YesidAlmanzaGamba/Thesis-Flight-Controller-Fixed-Wing/Documento/Sections/Abstract.tex

  \section{Abstract}

  This thesis addresses the design and implementation of a flight controller for fixed-wing unmanned aerial vehicles (UAVs), along with a ground control station for remote supervision. The proposed system enhances actuator capacity, integrates advanced sensors such as altimeters, barometers, GPS, and inertial sensors, and enables real-time visualization of critical parameters. Additionally, a system was developed to monitor and reconstruct the flight trajectory using geolocation and altitude data. This advancement represents a significant contribution to industrial applications requiring precision and constant UAV monitoring. A notable aspect is the transition from the traditional STM32 architecture to the ESP32-S3, improving system capabilities. This innovation significantly enhances data management and operational efficiency, providing UAV operators and researchers with a robust and reliable flight control system.\vspace{30 px}

\begin{center}
    \textbf{\LARGE{Resumen}} 
\end{center}

\vspace{10 px}

Esta tesis aborda el diseño e implementación de un controlador de vuelo para vehículos aéreos no tripulados (UAV) de ala fija, junto con una estación de control en tierra para supervisión remota. Se propone un sistema que mejora la capacidad de actuadores, integra sensores avanzados como altímetros, barómetros, GPS y sensores inerciales, y permite la visualización de parámetros críticos en tiempo real. Adicionalmente, se diseñó un sistema para monitorear y reconstruir la trayectoria de vuelo mediante datos de geolocalización y altitud. Este avance representa un aporte significativo para aplicaciones industriales que requieren precisión y monitoreo constante de UAVs. Un aspecto notable es el cambio de la arquitectura tradicional STM32 a la ESP32-S3, mejorando las capacidades del sistema. Esta innovación mejora significativamente la gestión de datos y la eficiencia operativa, impactando a operadores e investigadores de UAVs al proporcionar un sistema de control de vuelo robusto y fiable.
