YesidAlmanzaGamba/Thesis-Flight-Controller-Fixed-Wing/Documento/main.tex

\makeatletter
\providecommand{\sf@counterlist}{}
\makeatother
\documentclass[journal,onecolumn]{IEEEtran}
\usepackage[letterpaper,bindingoffset=0.0in,left=28mm,right=28mm,top=28mm,bottom=28mm,%
            footskip=16mm]{geometry}
\usepackage[table,xcdraw]{xcolor}
\usepackage{amsmath,amsthm,amssymb,amsfonts}
\usepackage[utf8]{inputenc}
\usepackage[english, spanish]{babel}
\setlength{\parindent}{0in}
\usepackage{float}
\usepackage[export]{adjustbox}
\usepackage[labelfont=bf]{caption}
\usepackage{subcaption}
\usepackage[arrowdel]{physics}
\usepackage{wrapfig}
\usepackage{mathtools}
\usepackage{bm}
\usepackage{esvect}
\usepackage{array}
\usepackage[hidelinks, colorlinks=true, urlcolor=gray, citecolor=gray]{hyperref}
\usepackage{enumerate}
\usepackage{chemfig}
\usepackage{enumitem}
\usepackage{sectsty}
\allsectionsfont{\bfseries\centering}
\usepackage{url}
\usepackage[T1]{fontenc}
\usepackage{titling}
\usepackage{letltxmacro}
\usepackage{textcomp}
\usepackage{fancyhdr}
\usepackage{fancyvrb}
\usepackage{lipsum}
\usepackage{authblk}
\usepackage{multirow}
\usepackage{makecell}
\usepackage{multicol}
\usepackage{resizegather}
\usepackage{subfig}
\usepackage{subfiles}
\usepackage{import}
\hyphenation{op-tical net-works semi-conduc-tor}
\usepackage{listings}
\usepackage{blindtext}
\setlength{\columnsep}{1cm}
\usepackage{appendix}
\usepackage{tocloft}
\usepackage{csquotes}
\usepackage[backend=biber,style=ieee]{biblatex}
\addbibresource{biblio.bib} % Add your .bib file here
\bibliography{references}
\usepackage{bookmark}
\usepackage{graphicx}
\usepackage{pgfgantt}
\usepackage{sectsty}
\usepackage{listings}
\usepackage{xcolor}
\usepackage{caption} % Asegúrate de que esta línea está presente
\usepackage{verbatim}
\definecolor{codegreen}{rgb}{0,0.6,0}
\definecolor{codegray}{rgb}{0.5,0.5,0.5}
\definecolor{codepurple}{rgb}{0.58,0,0.82}
\definecolor{backcolour}{rgb}{0.95,0.95,0.92}

\lstdefinestyle{mystyle}{
    backgroundcolor=\color{backcolour},   
    commentstyle=\color{codegreen},
    keywordstyle=\color{magenta},
    numberstyle=\tiny\color{codegray},
    stringstyle=\color{codepurple},
    basicstyle=\ttfamily\footnotesize,
    breakatwhitespace=false,         
    breaklines=true,                 
    captionpos=b,                    
    keepspaces=true,                 
    numbers=left,                    
    numbersep=5pt,                  
    showspaces=false,                
    showstringspaces=false,
    showtabs=false,                  
    tabsize=2
}

\lstset{style=mystyle}

\usepackage{titlesec}
\titleformat{\paragraph}[runin]
  {\normalfont\normalsize\bfseries} % Formato de texto
  {\thesubparagraph}{1em}{}         % Numeración y espaciado
\titlespacing*{\paragraph}{0pt}{1.5ex plus 1ex minus .2ex}{1em}

% Cambiar el estilo de numeración de secciones a números arábigos
\renewcommand{\thesection}{\arabic{section}}
\renewcommand{\thesubsection}{\thesection.\arabic{subsection}}
\renewcommand{\thesubsubsection}{\thesubsection.\arabic{subsubsection}}

\newenvironment{sbmatrix}[1]
 {\def\mysubscript{#1}\mathop\bgroup\begin{bmatrix}}
 {\end{bmatrix}\egroup_{\textstyle\mathstrut\mysubscript}}

%\input{Comandos.tex} %Incluye todos los comandos usados. 
%***************************%

\input{Configuracion.tex} %Incluye todos los cambios en configuración del documento. 

%***************************%

%Comienzo del documento.
\date{}

\begin{document}

    \begin{titlepage}
    \centering
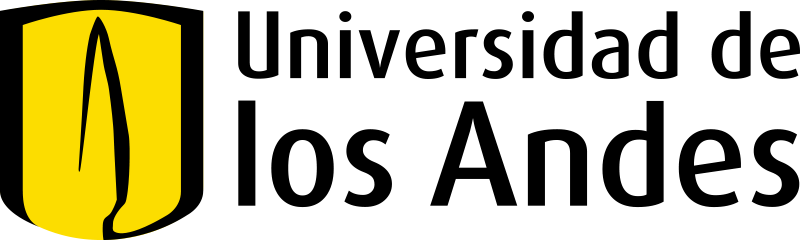
[picture p83: Documento/Documentos/logo_uniandes.png]
    \\

    \vspace{1cm}
    %{\scshape\Large Departamento de Ingeniería Electrónica Universidad de los Andes\par}
    \vspace{3cm}
    {\scshape \Large \textbf{desarrollo e implementación de un controlador de vuelo y estación de control de tierra para un uav de ala fija } \par}
    \vspace{3cm}
    {\itshape\Large Proyecto de Grado \par}
    \vfill
    {\itshape\Large Programa de Ingeniería electrónica Universidad de los Andes\par}
    {\Large Autor: \par}
    {\Large Yesid Camilo Almanza Gamba \par}
    \vfill
    {\Large Profesora Asesora: \par}
    {\Large Alba Ávila Bernal  \par}
    \vfill
    {\Large Junio 2024 \par}
    \end{titlepage}

\clearpagen 

\pagestyle{plain}
\tableofcontents
\clearpage
\makeatletter
\listoffigures
\makeatother
\clearpage
\makeatletter
\listoftables
\makeatother
\clearpage
\input{Sections/Abstract}
\clearpage
\input{Sections/Agradecimientos}
\clearpage

\input{Sections/Introducción}
\input{Sections/Estado_del_Arte}
\clearpage
\input{Sections/Planteamiento_problema}
\clearpage
\input{Sections/Objetivos}
\clearpage
\input{Sections/Marco Teórico}
\clearpage
\input{Sections/Metodología}
\clearpage
\input{Sections/Hardware}
\input{Sections/Enclousure}
\input{Sections/Firmware}
\clearpage
\input{Sections/Interfaz}
\clearpage

\input{Sections/Costos}
\clearpage
\input{Sections/pruebas_funcionamiento}
%\input{Sections/vuelo}
%\clearpage
\input{Sections/prueba_vuelo}
\clearpage
\input{Sections/resultados}

\clearpage

\input{Sections/conclusiones}
\clearpage
\printbibliography
\input{Sections/anexos}
\clearpage
\begin{comment}
 sdfsd
\end{comment}

\end{document}
