YesidAlmanzaGamba/Thesis-Flight-Controller-Fixed-Wing/Documento/Documentos/Yumbo-Solar.png

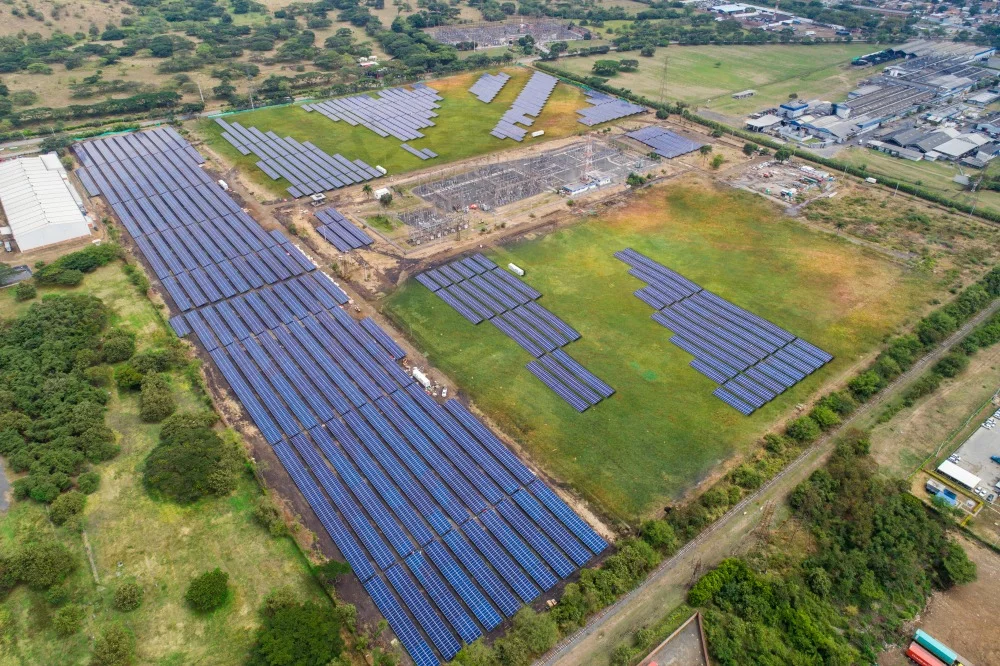
Documento/Documentos/Yumbo-Solar.png
