YesidAlmanzaGamba/Thesis-Flight-Controller-Fixed-Wing/Documento/Imagenes/Anexos/costos.png

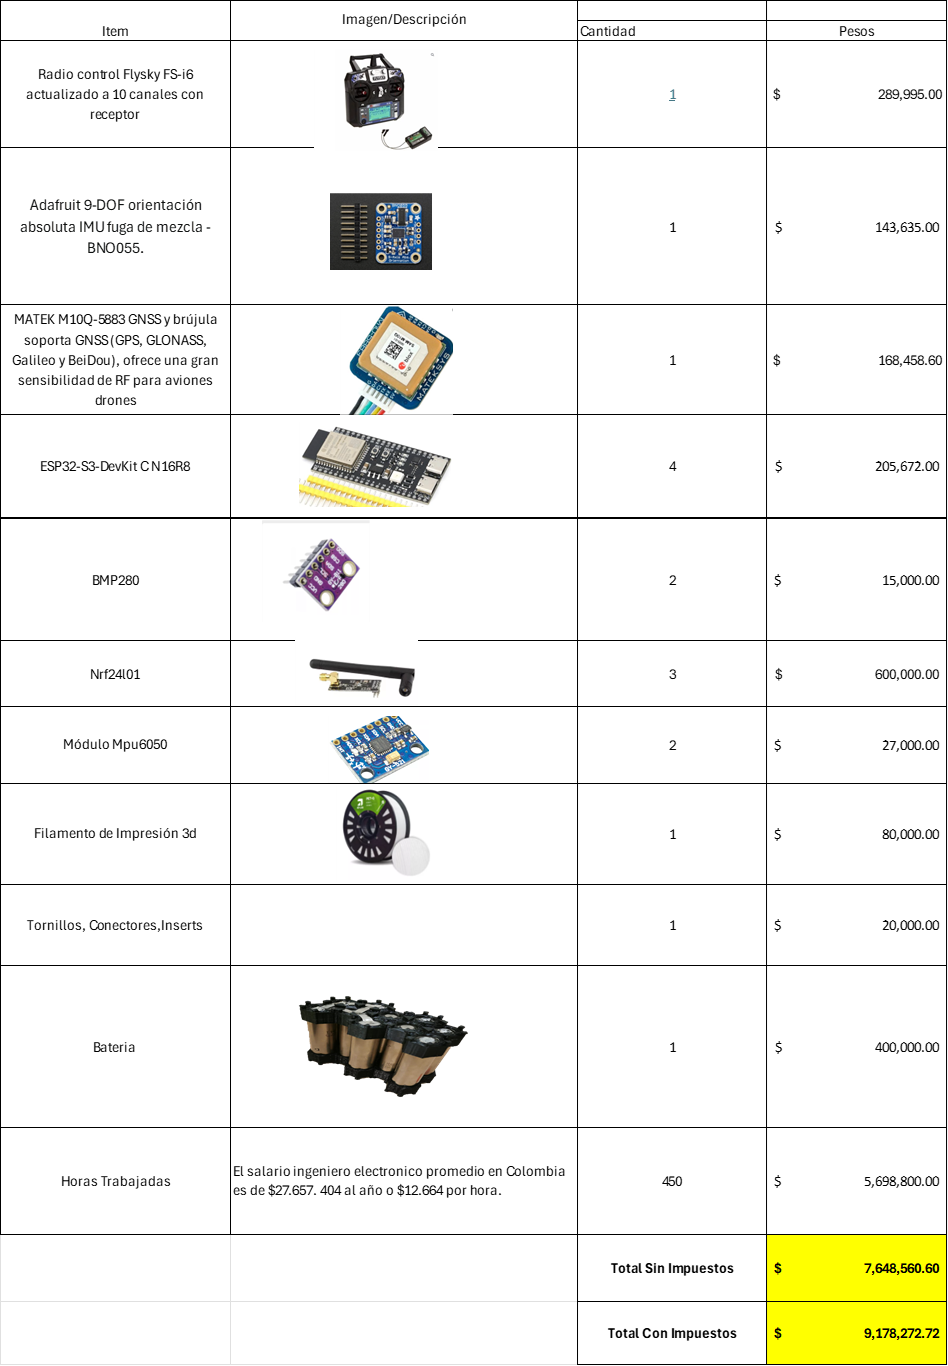
Documento/Imagenes/Anexos/costos.png
