YesidAlmanzaGamba/Thesis-Flight-Controller-Fixed-Wing/Documento/Imagenes/Marco Teorico/modulo-lector-de-memoria-micro-sd.jpg

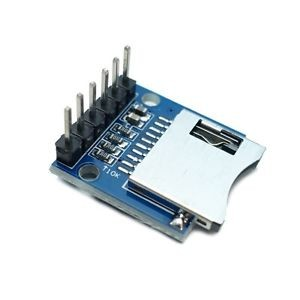
Documento/Imagenes/Marco Teorico/modulo-lector-de-memoria-micro-sd.jpg
