YesidAlmanzaGamba/Thesis-Flight-Controller-Fixed-Wing/Documento/Imagenes/Marco Teorico/waitpoints.png

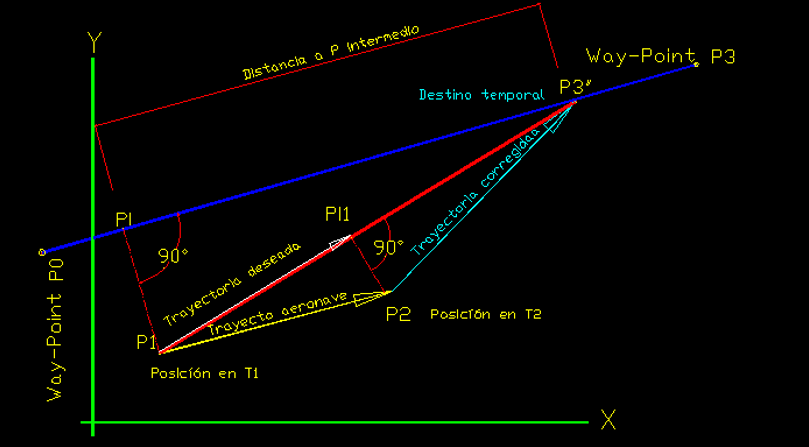
Documento/Imagenes/Marco Teorico/waitpoints.png
