YesidAlmanzaGamba/Thesis-Flight-Controller-Fixed-Wing/Documento/Imagenes/Metodologia/arquiectura.png

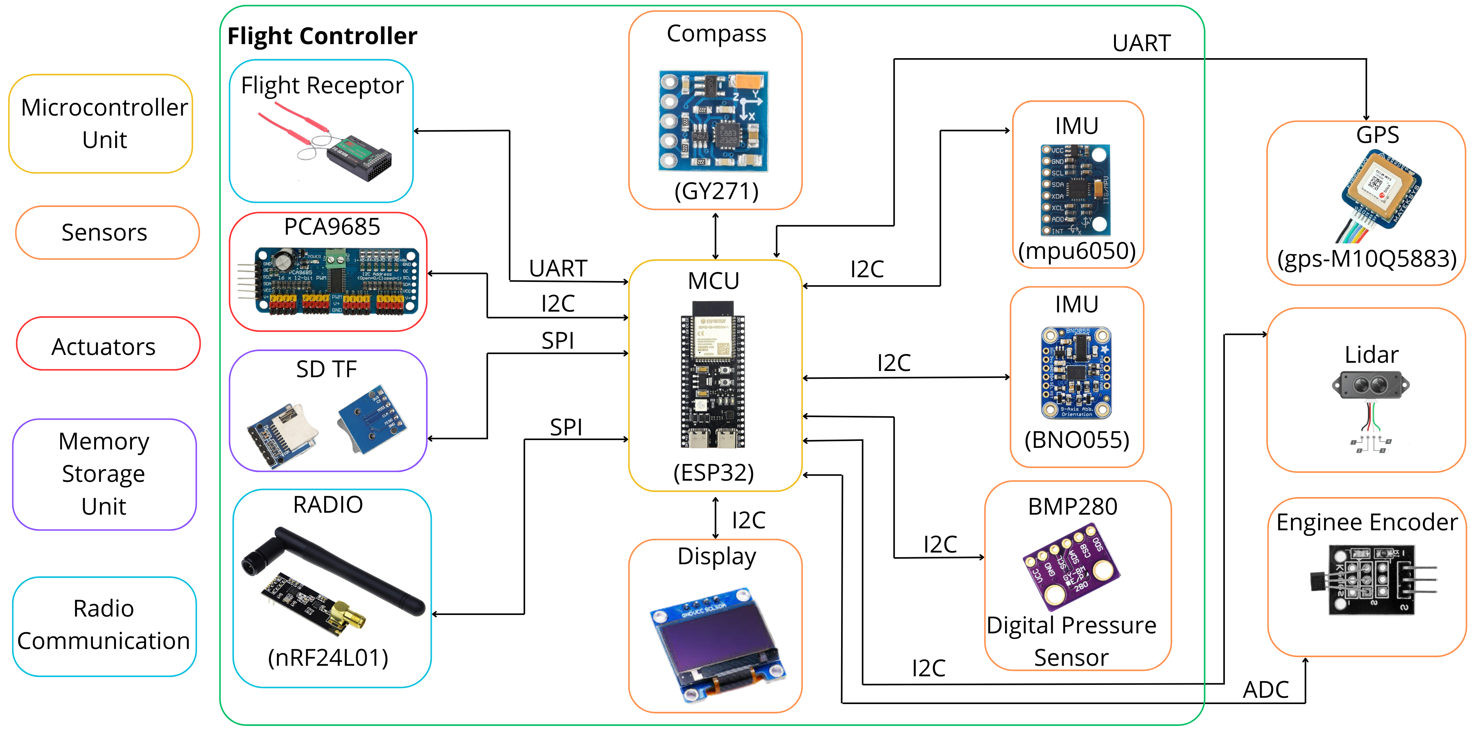
Documento/Imagenes/Metodologia/arquiectura.png
