YesidAlmanzaGamba/Thesis-Flight-Controller-Fixed-Wing/Documento/Imagenes/Metodologia/bloques.png

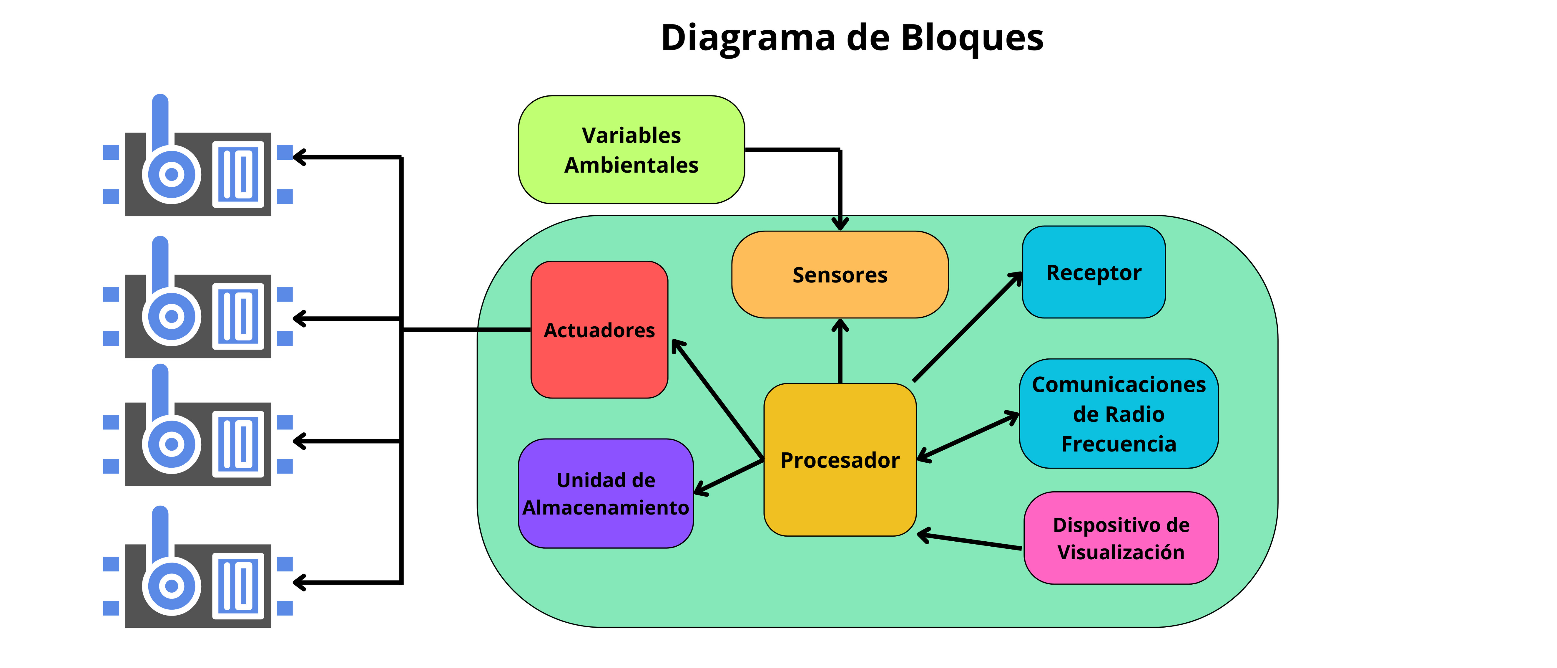
Documento/Imagenes/Metodologia/bloques.png
