YesidAlmanzaGamba/Thesis-Flight-Controller-Fixed-Wing/Documento/Imagenes/Metodologia/PCB_2.0.png

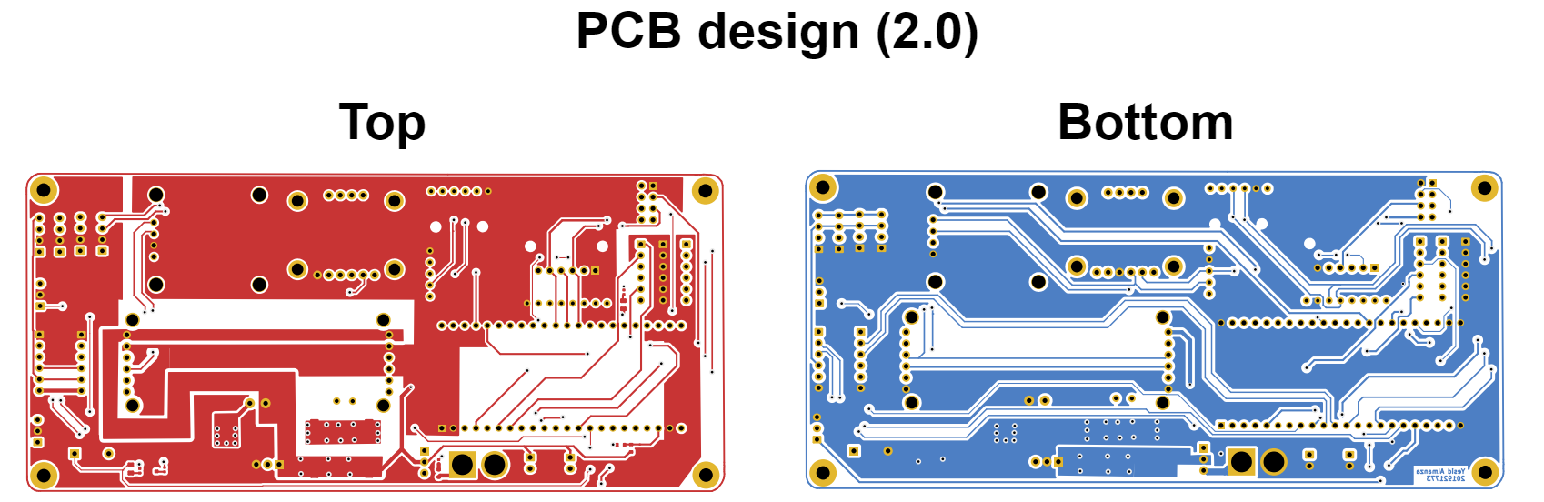
Documento/Imagenes/Metodologia/PCB_2.0.png
