YesidAlmanzaGamba/Thesis-Flight-Controller-Fixed-Wing/Documento/Imagenes/Metodologia/sujecion_electronica.png

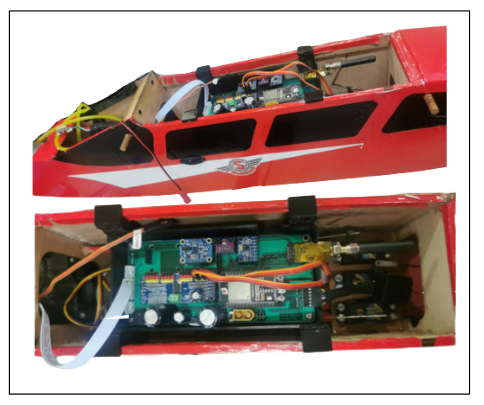
Documento/Imagenes/Metodologia/sujecion_electronica.png
