YesidAlmanzaGamba/Thesis-Flight-Controller-Fixed-Wing/Documento/presupuesto.png

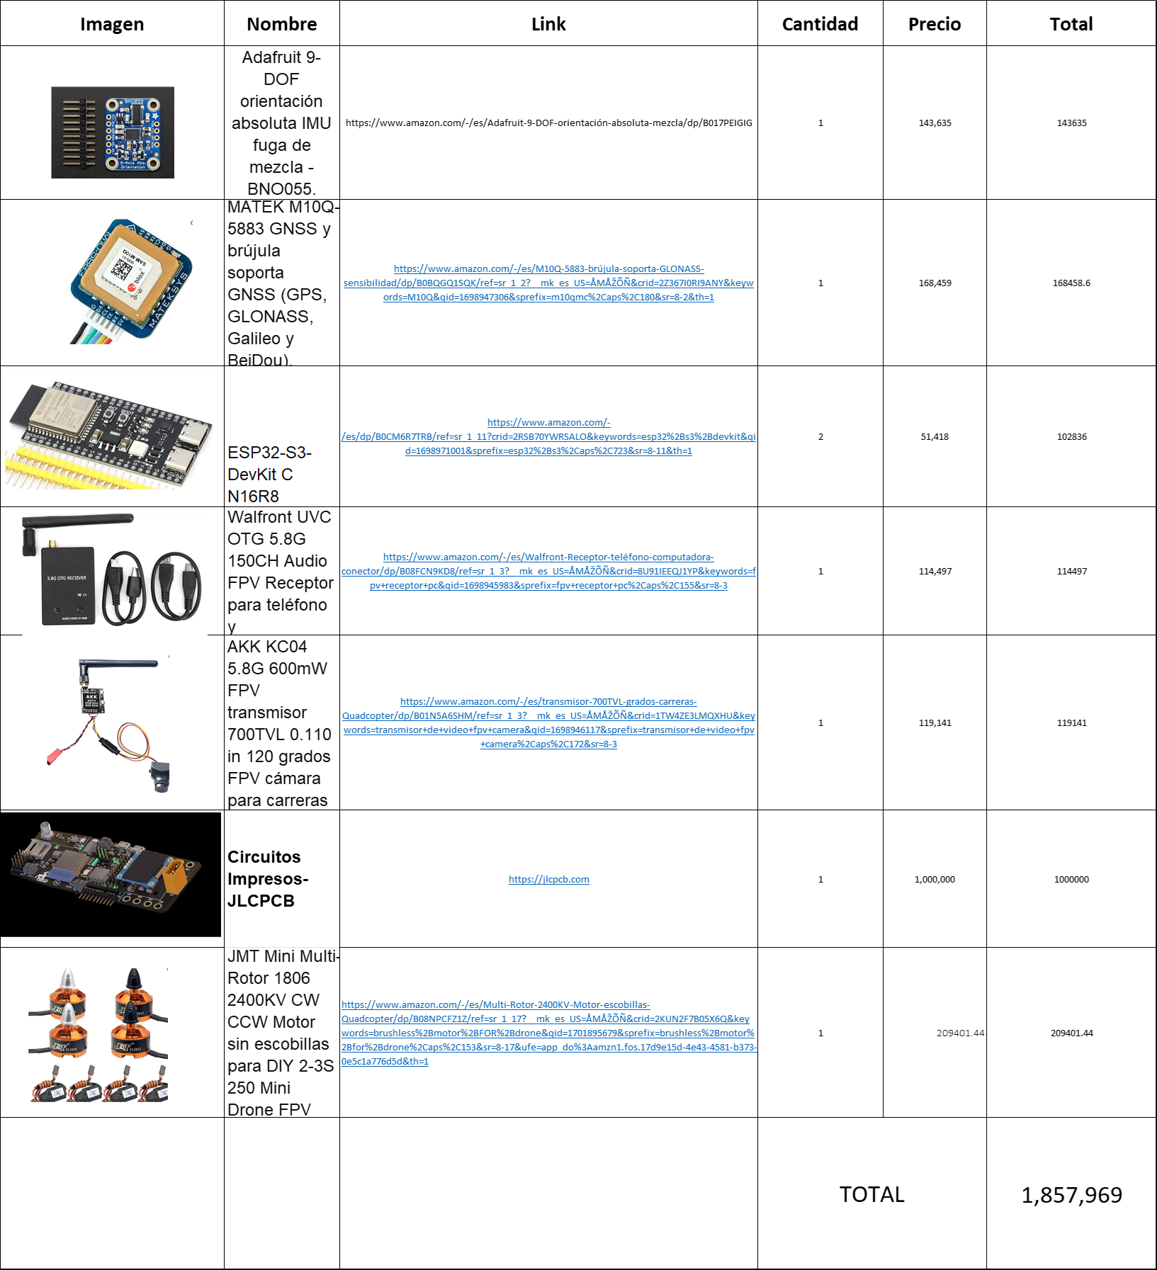
Documento/presupuesto.png
