YesidAlmanzaGamba/Thesis-Flight-Controller-Fixed-Wing/PCB/Huellas y Simbolos/gy-271/GY-271 HMC5883L Triple 3 Axis Digital Compass Magnetometer.jpg

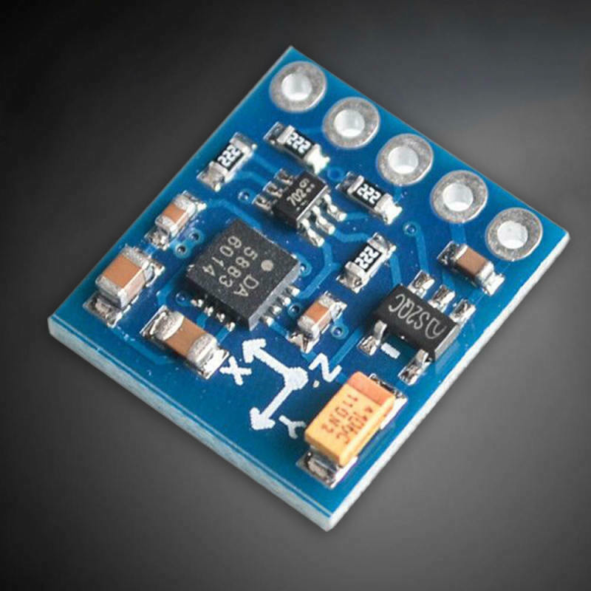
PCB/Huellas y Simbolos/gy-271/GY-271 HMC5883L Triple 3 Axis Digital Compass Magnetometer.jpg
