YesidAlmanzaGamba/Thesis-Flight-Controller-Fixed-Wing/src/interfazWave/img/aircraft-36298.png

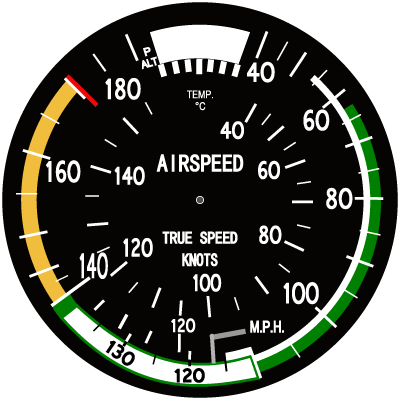
src/interfazWave/img/aircraft-36298.png
