YesidAlmanzaGamba/Thesis-Flight-Controller-Fixed-Wing/src/interfazWave/img/apps (1).png

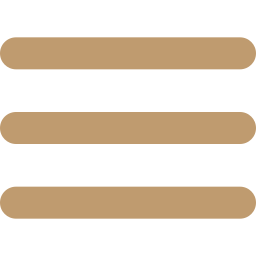
src/interfazWave/img/apps (1).png
