YesidAlmanzaGamba/Thesis-Flight-Controller-Fixed-Wing/src/interfazWave/img/Attitude_indicator_level_flight.png

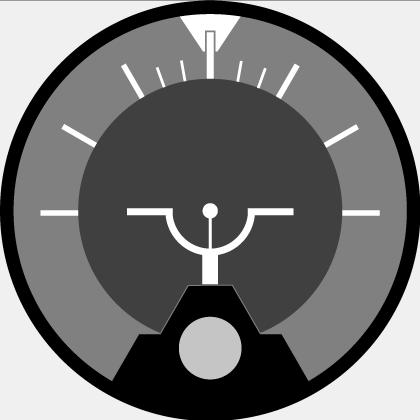
src/interfazWave/img/Attitude_indicator_level_flight.png
