YesidAlmanzaGamba/Thesis-Flight-Controller-Fixed-Wing/src/interfazWave/img/chart-line-up (1).png

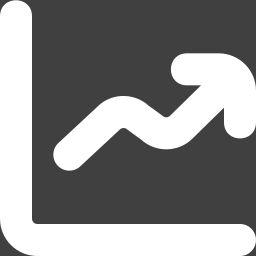
src/interfazWave/img/chart-line-up (1).png
