YesidAlmanzaGamba/Thesis-Flight-Controller-Fixed-Wing/src/interfazWave/img/chart-line-up.png

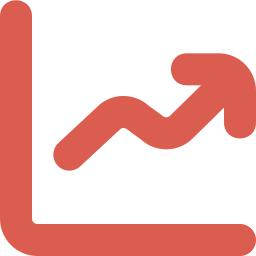
src/interfazWave/img/chart-line-up.png
