YesidAlmanzaGamba/Thesis-Flight-Controller-Fixed-Wing/src/interfazWave/img/cubes.png

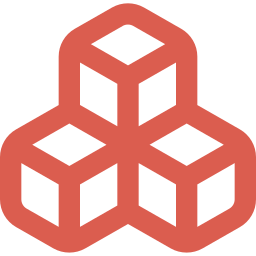
src/interfazWave/img/cubes.png
