YesidAlmanzaGamba/Thesis-Flight-Controller-Fixed-Wing/src/interfazWave/img/Heading_indicator.png

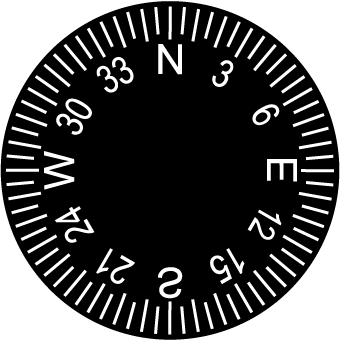
src/interfazWave/img/Heading_indicator.png
