YesidAlmanzaGamba/Thesis-Flight-Controller-Fixed-Wing/src/interfazWave/img/istockphoto-546787274-612x612.png

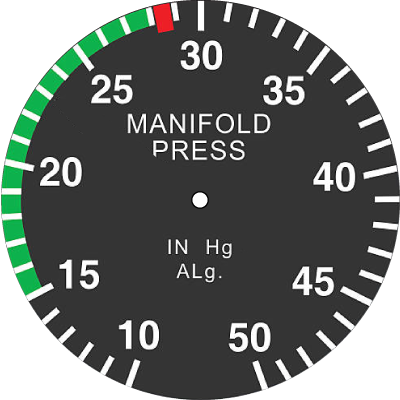
src/interfazWave/img/istockphoto-546787274-612x612.png
