YesidAlmanzaGamba/Thesis-Flight-Controller-Fixed-Wing/src/interfazWave/img/triangle-warning (1).png

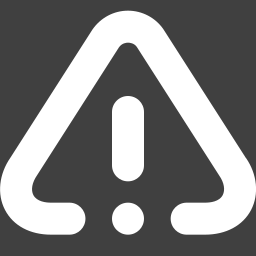
src/interfazWave/img/triangle-warning (1).png
