YesidAlmanzaGamba/Thesis-Flight-Controller-Fixed-Wing/src/interfazWave/img/triangle-warning.png

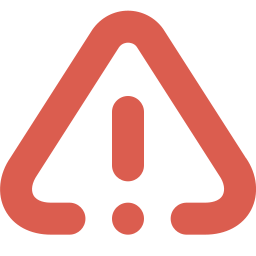
src/interfazWave/img/triangle-warning.png
