YesidAlmanzaGamba/Thesis-Flight-Controller-Fixed-Wing/src/interfazWave/img/Untitled-7.png

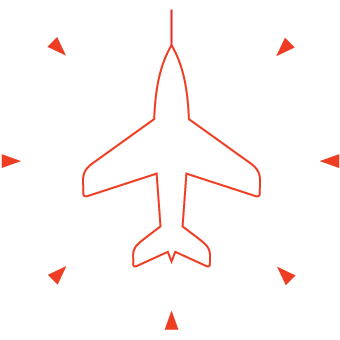
src/interfazWave/img/Untitled-7.png
