YesidAlmanzaGamba/Thesis-Flight-Controller-Fixed-Wing/src/interfazWave/img/Untitled-8.png

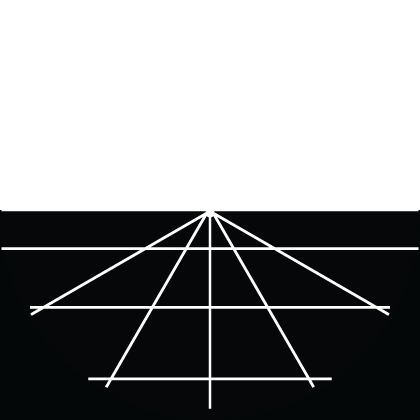
src/interfazWave/img/Untitled-8.png
