YesidAlmanzaGamba/Thesis-Flight-Controller-Fixed-Wing/src/interfazWave/img/Untitled-9.png

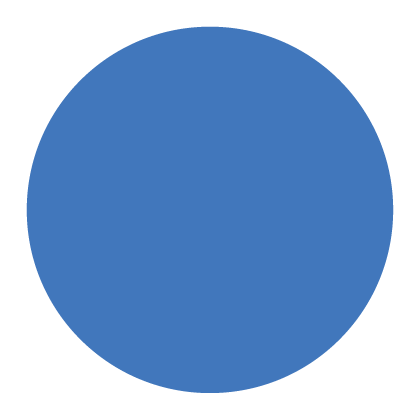
src/interfazWave/img/Untitled-9.png
