YesidAlmanzaGamba/Thesis-Flight-Controller-Fixed-Wing/src/interfazWave/img/Untitled-10.png

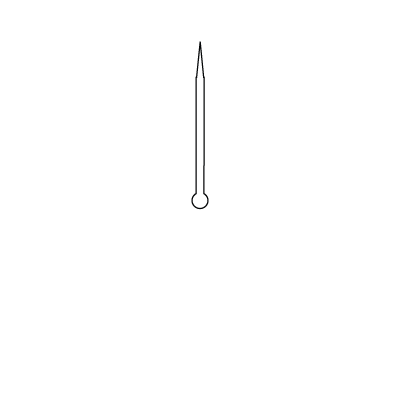
src/interfazWave/img/Untitled-10.png
