YesidAlmanzaGamba/Thesis-Flight-Controller-Fixed-Wing/src/interfazWave/img/Untitled-11.png

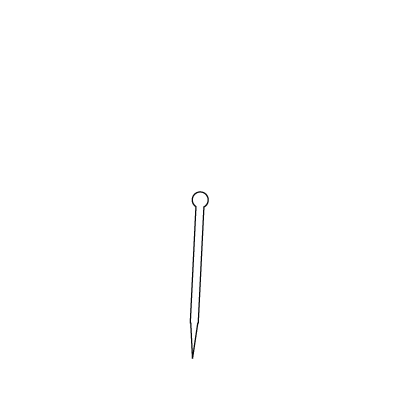
src/interfazWave/img/Untitled-11.png
