YesidAlmanzaGamba/Thesis-Flight-Controller-Fixed-Wing/PCB/Huellas y Simbolos/nrf24l01/NRF24L01L + Antenna 2.4 GHz/Antenna assy.SLDASM

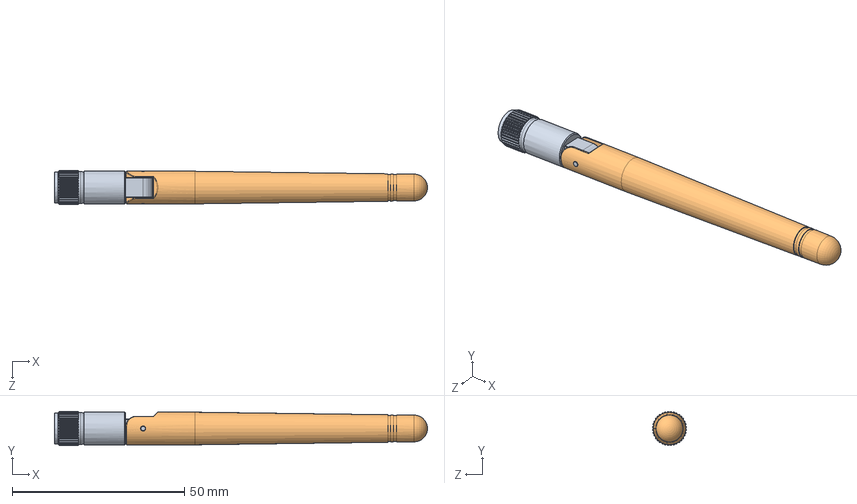
[picture p109: CAD file, 2024-11-01]
PCB/Huellas y Simbolos/nrf24l01/NRF24L01L + Antenna 2.4 GHz/Antenna assy.SLDASM
108.2 x 9.98 x 9.98 mm
Antenna base
Antenna top
