YesidAlmanzaGamba/Thesis-Flight-Controller-Fixed-Wing/PCB/Huellas y Simbolos/nrf24l01/NRF24L01L + Antenna 2.4 GHz/NRF24L01L+Antenna.SLDASM

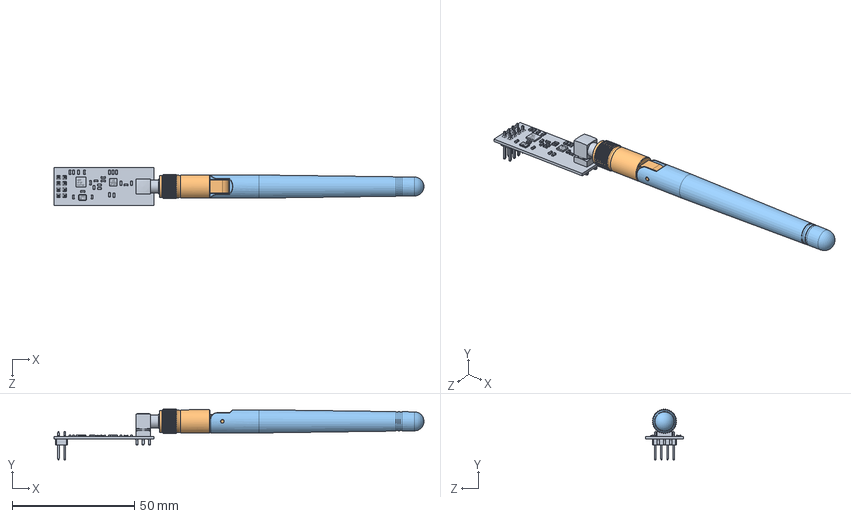
[picture p110: CAD file, 2024-11-01]
PCB/Huellas y Simbolos/nrf24l01/NRF24L01L + Antenna 2.4 GHz/NRF24L01L+Antenna.SLDASM
151.4 x 20.7 x 15.5 mm
NRF24L01L
Antenna base
Antenna top
