YesidAlmanzaGamba/Thesis-Flight-Controller-Fixed-Wing/PCB/Huellas y Simbolos/gy-271/GY-271 HMC5883L Triple 3 Axis Digital Compass.step

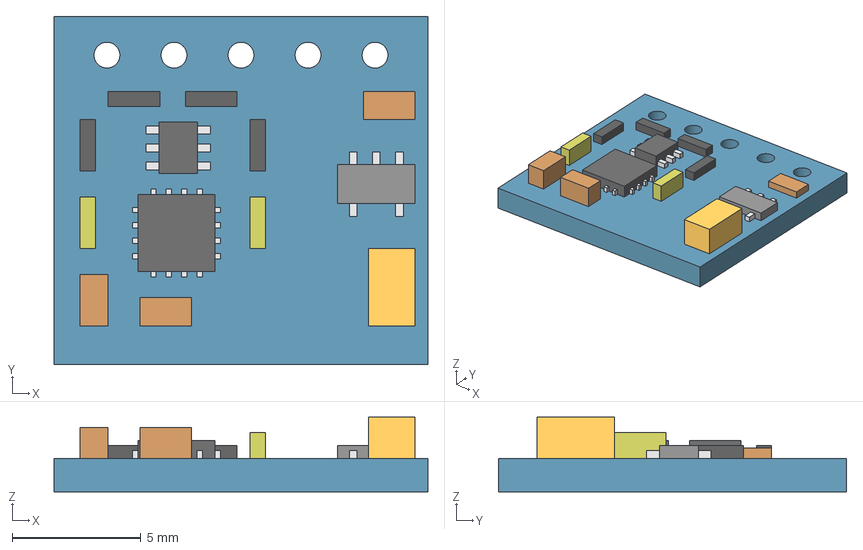
[picture p111: CAD file, 2024-11-01]
PCB/Huellas y Simbolos/gy-271/GY-271 HMC5883L Triple 3 Axis Digital Compass.step
14.5 x 13.5 x 2.90 mm
