YesidAlmanzaGamba/Thesis-Flight-Controller-Fixed-Wing/PCB/Huellas y Simbolos/nrf24l01/NRF24L01L + Antenna 2.4 GHz/Antenna top.SLDPRT

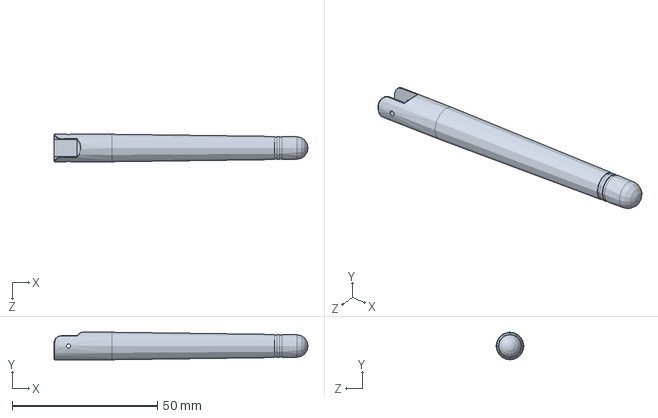
[picture p112: CAD file, 2024-11-01]
PCB/Huellas y Simbolos/nrf24l01/NRF24L01L + Antenna 2.4 GHz/Antenna top.SLDPRT
87.5 x 9.50 x 9.50 mm
