YesidAlmanzaGamba/Thesis-Flight-Controller-Fixed-Wing/PCB/Huellas y Simbolos/XT60-M/XT60-M.step

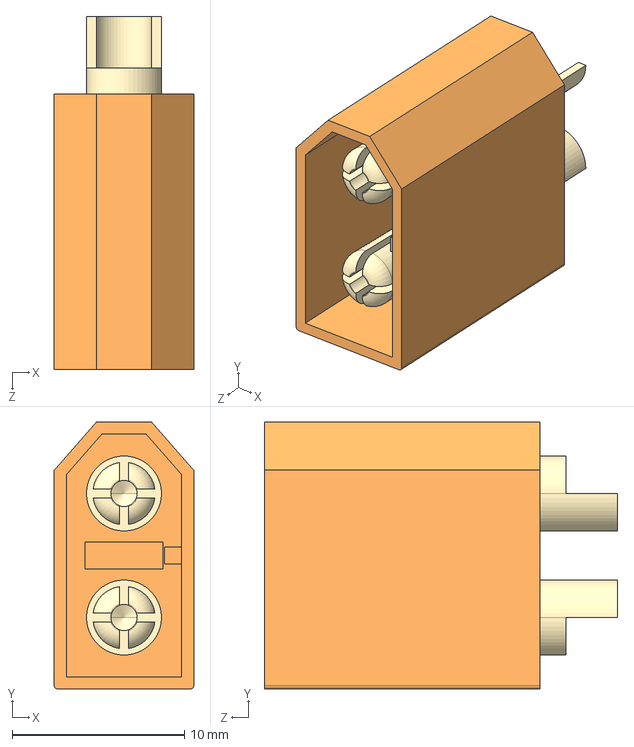
[picture p113: CAD file, 2024-11-01]
PCB/Huellas y Simbolos/XT60-M/XT60-M.step
8.10 x 15.5 x 20.5 mm
