YesidAlmanzaGamba/Thesis-Flight-Controller-Fixed-Wing/PCB/Modelos 3d/PAJ7620.step

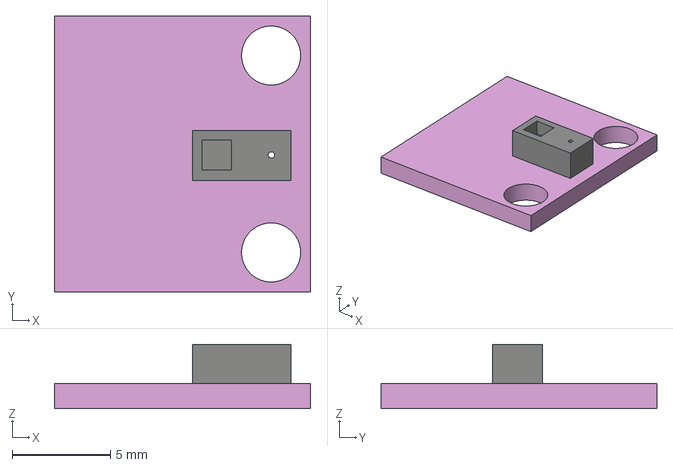
[picture p114: CAD file, 2024-11-01]
PCB/Modelos 3d/PAJ7620.step
13.0 x 14.0 x 3.27 mm
