YesidAlmanzaGamba/Thesis-Flight-Controller-Fixed-Wing/src/interfazWave/plane.STL

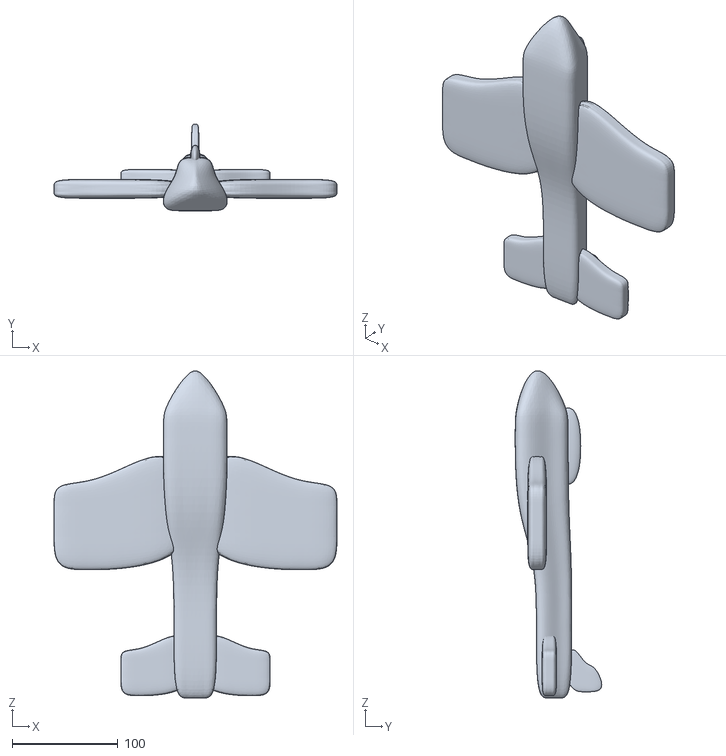
[picture p115: CAD file, 2024-11-07]
src/interfazWave/plane.STL
267.0 x 81.7 x 308.6
