YesidAlmanzaGamba/Thesis-Flight-Controller-Fixed-Wing/PCB/Modelos 3d/GY_906.STEP

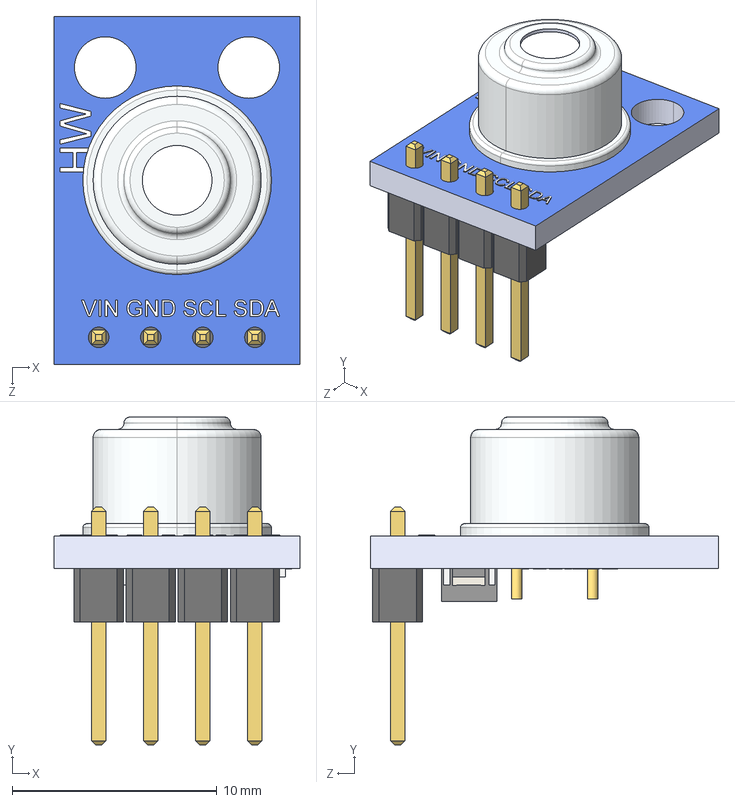
[picture p116: CAD file, 2024-11-01]
PCB/Modelos 3d/GY_906.STEP
12.0 x 16.0 x 17.0 mm
IRTS_pcb
IRTS_pin x 4
IRTS_reistor x 2
IRTS_capacitor x 2
IRTS_Transistor
IRTS_IRSensor
