YesidAlmanzaGamba/Thesis-Flight-Controller-Fixed-Wing/PCB/Modelos 3d/BH1750.step

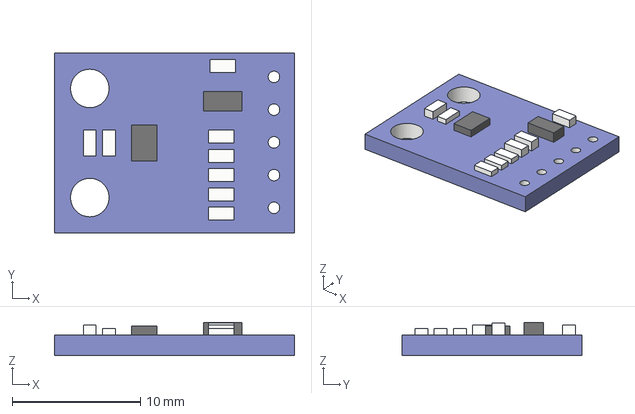
[picture p117: CAD file, 2024-11-01]
PCB/Modelos 3d/BH1750.step
18.7 x 14.0 x 2.60 mm
