YesidAlmanzaGamba/Thesis-Flight-Controller-Fixed-Wing/PCB/Huellas y Simbolos/nrf24l01/NRF24L01L + Antenna 2.4 GHz/NRF24L01L.SLDPRT

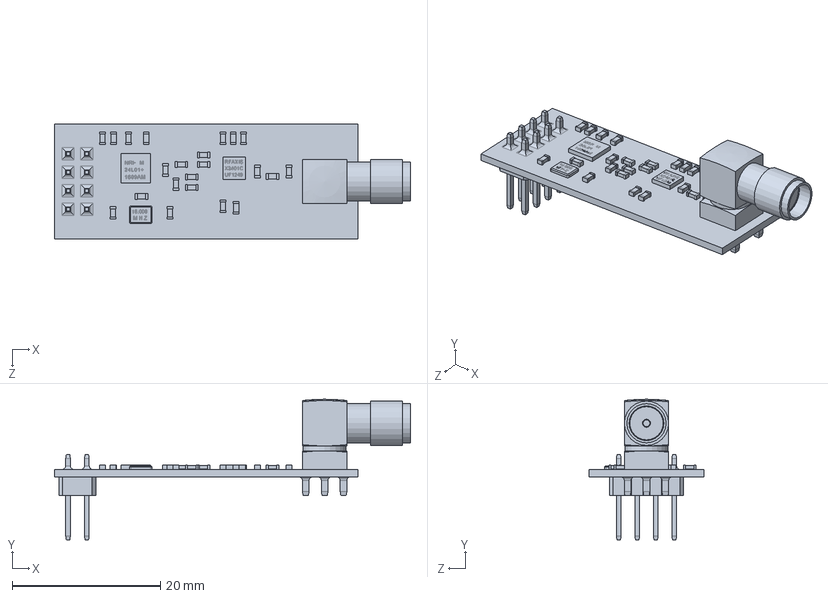
[picture p118: CAD file, 2024-11-01]
PCB/Huellas y Simbolos/nrf24l01/NRF24L01L + Antenna 2.4 GHz/NRF24L01L.SLDPRT
48.1 x 19.0 x 15.5 mm
