YesidAlmanzaGamba/Thesis-Flight-Controller-Fixed-Wing/PCB/Modelos 3d/tsl2561.step

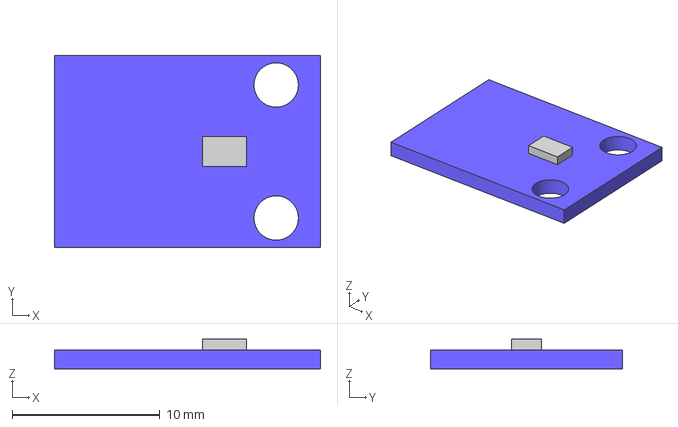
[picture p119: CAD file, 2024-11-01]
PCB/Modelos 3d/tsl2561.step
18.0 x 13.0 x 2.00 mm
