YesidAlmanzaGamba/Thesis-Flight-Controller-Fixed-Wing/PCB/Modelos 3d/si7021.step

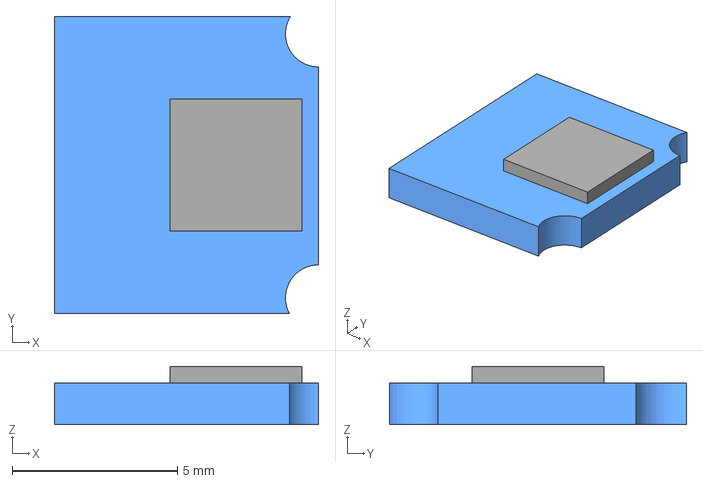
[picture p121: CAD file, 2024-11-01]
PCB/Modelos 3d/si7021.step
8.00 x 9.00 x 1.77 mm
