YesidAlmanzaGamba/Thesis-Flight-Controller-Fixed-Wing/PCB/Modelos 3d/adxl345.step

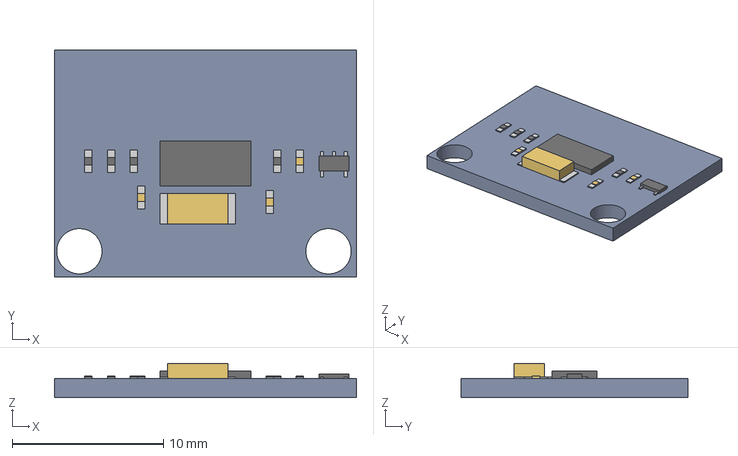
[picture p122: CAD file, 2024-11-01]
PCB/Modelos 3d/adxl345.step
20.0 x 15.0 x 2.27 mm
