YesidAlmanzaGamba/Thesis-Flight-Controller-Fixed-Wing/PCB/Modelos 3d/INA219.STEP

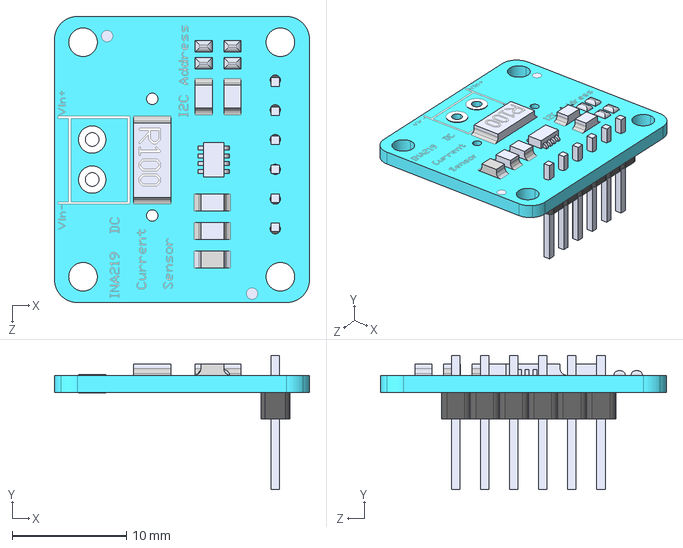
[picture p123: CAD file, 2024-11-01]
PCB/Modelos 3d/INA219.STEP
22.3 x 11.8 x 25.0 mm
6 Header-Pin
Placa
