YesidAlmanzaGamba/Thesis-Flight-Controller-Fixed-Wing/PCB/Modelos 3d/4646 BNO055 Stemma.step

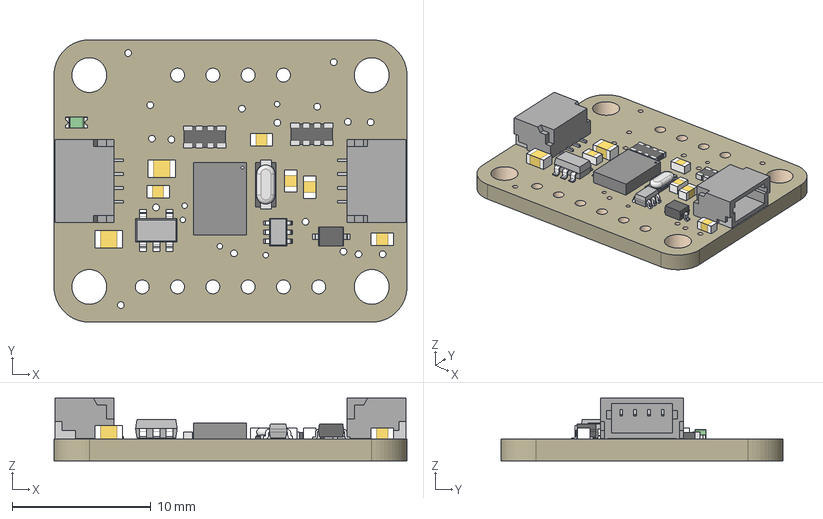
[picture p124: CAD file, 2024-11-01]
PCB/Modelos 3d/4646 BNO055 Stemma.step
25.4 x 20.3 x 4.53 mm
Board
BNO055
10K x 5
1n4148
10uF x 2
AP2112K-3.3
10K_1 x 2
BSS138
STEMMA_I2C_QT x 2
GREEN
