YesidAlmanzaGamba/Thesis-Flight-Controller-Fixed-Wing/PCB/Modelos 3d/bme280.step

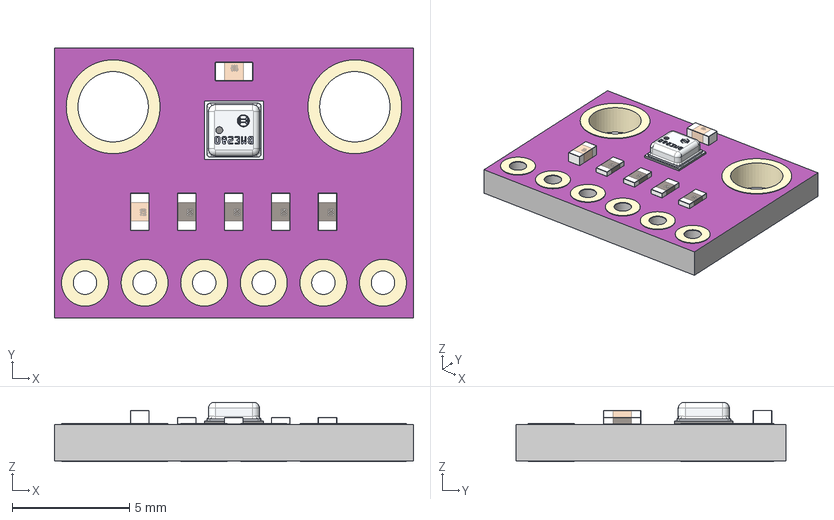
[picture p125: CAD file, 2024-11-01]
PCB/Modelos 3d/bme280.step
15.3 x 11.5 x 2.52 mm
Komponente1
Komponente2
Komponente3
Komponente4
Komponente5
Komponente6
Komponente7
Komponente8
Beschriftung
C0603 x 2
R0603 x 4
BME280
