YesidAlmanzaGamba/Thesis-Flight-Controller-Fixed-Wing/PCB/Modelos 3d/MPU_6050.step

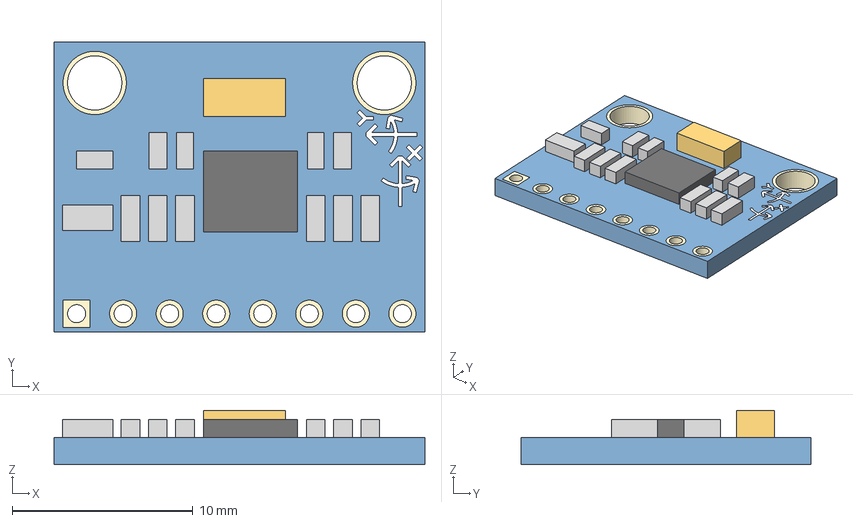
[picture p126: CAD file, 2024-11-01]
PCB/Modelos 3d/MPU_6050.step
20.5 x 16.0 x 3.00 mm
