YesidAlmanzaGamba/Thesis-Flight-Controller-Fixed-Wing/PCB/Modelos 3d/bmp180.step

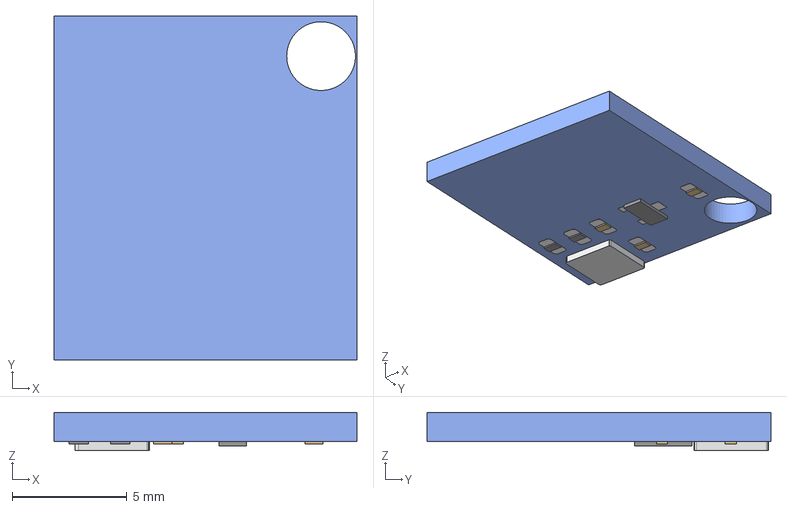
[picture p127: CAD file, 2024-11-01]
PCB/Modelos 3d/bmp180.step
13.2 x 15.0 x 1.67 mm
