YesidAlmanzaGamba/Thesis-Flight-Controller-Fixed-Wing/PCB/Modelos 3d/MPL3115A2.step

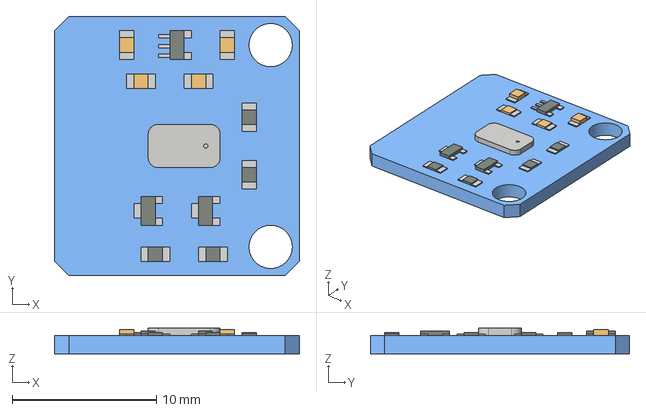
[picture p128: CAD file, 2024-11-01]
PCB/Modelos 3d/MPL3115A2.step
17.0 x 18.0 x 1.77 mm
