YesidAlmanzaGamba/Thesis-Flight-Controller-Fixed-Wing/PCB/Modelos 3d/audio_3.5mm_trrs.step

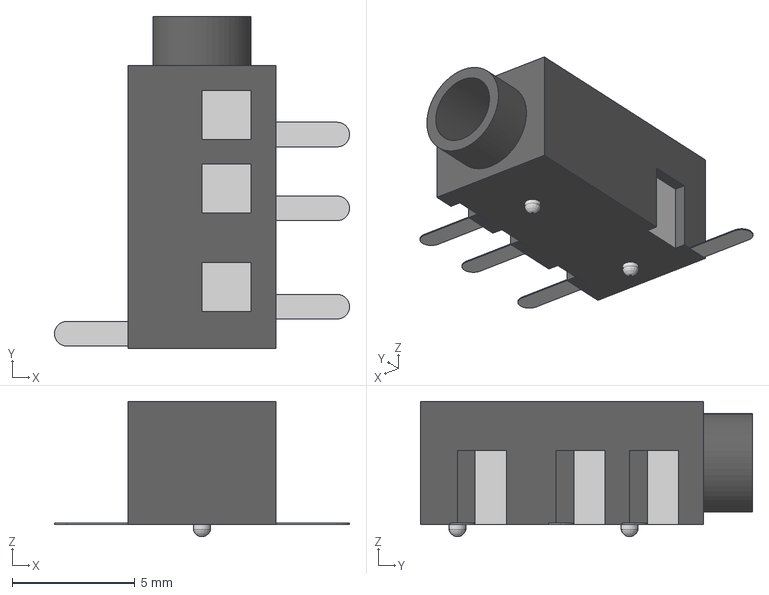
[picture p129: CAD file, 2024-11-01]
PCB/Modelos 3d/audio_3.5mm_trrs.step
12.0 x 13.5 x 5.50 mm
