YesidAlmanzaGamba/Thesis-Flight-Controller-Fixed-Wing/(list of files, cad)

Other CAD files:
PCB/Huellas y Simbolos/gy-271/GY-271 HMC5883L Triple 3 Axis Digital Compass.stl
PCB/Huellas y Simbolos/usini_kicad/usini_kicad_sensors-main/sources/fusion360/MPL3115A2.f3d
PCB/Huellas y Simbolos/usini_kicad/usini_kicad_sensors-main/sources/fusion360/PAJ7620.f3d
PCB/Huellas y Simbolos/usini_kicad/usini_kicad_sensors-main/sources/fusion360/adxl345.f3d
PCB/Huellas y Simbolos/usini_kicad/usini_kicad_sensors-main/sources/fusion360/audio_3.5mm_trrs.f3d
PCB/Huellas y Simbolos/usini_kicad/usini_kicad_sensors-main/sources/fusion360/bmp180.f3d
PCB/Huellas y Simbolos/usini_kicad/usini_kicad_sensors-main/sources/fusion360/module_si7021.f3d
PCB/Huellas y Simbolos/usini_kicad/usini_kicad_sensors-main/sources/fusion360/tsl2561.f3d
PCB/Modelos 3d/MAX30102.step
