YesidAlmanzaGamba/Thesis-Flight-Controller-Fixed-Wing/Documento/Imagenes/Metodologia/pcb_ensamblada.png

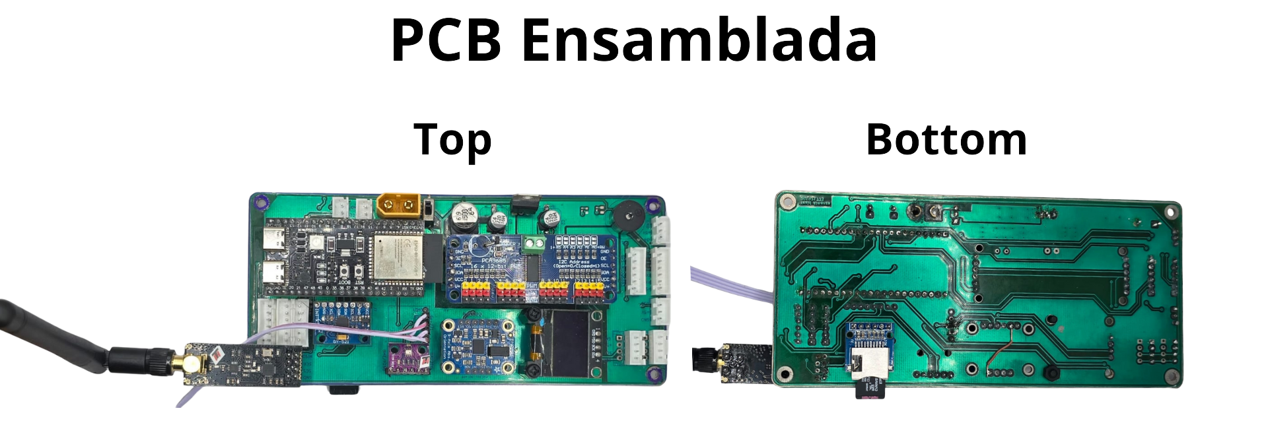
Documento/Imagenes/Metodologia/pcb_ensamblada.png
