YesidAlmanzaGamba/Thesis-Flight-Controller-Fixed-Wing/flight_tests/test_1/cvs_files/Recepcion/recepcion avion 3.csv

Tiempo | Latitud | Longitud | Altitud | Velocidad del aire | Presión | Yaw | Pitch | Roll | Presion del aire(PSI) | serv0 | serv1 | serv2 | serv3
3 | 20.464207 | 395.000000 | 379.00 | 229.00 | 393.00 | 164.00 | 0.00 | 33.44 | 0.00 | -74.16 | 2571.18 | 0.00 | 750.99 | 4.00000
