YesidAlmanzaGamba/Thesis-Flight-Controller-Fixed-Wing/flight_tests/test_0_ML/csv_files/dataSaved_4.csv

Tiempo | Latitud | Longitud | Altitud | Velocidad del aire | Presión | Yaw | Pitch | Roll | Presion del aire(PSI) | serv0 | serv1 | serv2 | serv3
3 | 0.000000 | 0.000000 | 2605.68 | 0.00 | 747.73 | 273.12 | 1.25 | 91.19 | 0.00 | 529.00 | 376.00 | 229.00 | 393.00
 | 0.02200
0 | 0.000000 | 0.000000 | 2605.68 | 0.00 | 747.73 | 273.12 | 1.25 | 91.19 | 0.00 | 529.00 | 376.00 | 229.00 | 393.00
 | 0.02200
0 | 0.000000 | 0.000000 | 2605.74 | 0.00 | 747.73 | 273.12 | 1.25 | 91.19 | 0.00 | 529.00 | 376.00 | 229.00 | 393.00
 | 0.02400
0 | 0.000000 | 0.000000 | 2605.74 | 0.00 | 747.73 | 273.12 | 1.25 | 91.19 | 0.00 | 529.00 | 376.00 | 229.00 | 393.00
 | 0.02400
0 | 0.000000 | 0.000000 | 2605.74 | 0.00 | 747.73 | 273.12 | 1.25 | 91.19 | 0.00 | 529.00 | 376.00 | 229.00 | 393.00
 | 0.02400
0 | 0.000000 | 0.000000 | 2605.74 | 0.00 | 747.73 | 273.12 | 1.25 | 91.19 | 0.00 | 529.00 | 376.00 | 229.00 | 393.00
 | 0.02400
0 | 0.000000 | 0.000000 | 2605.74 | 0.00 | 747.73 | 273.12 | 1.25 | 91.19 | 0.00 | 529.00 | 376.00 | 229.00 | 393.00
 | 0.02400
0 | 0.000000 | 0.000000 | 2605.74 | 0.00 | 747.73 | 273.12 | 1.25 | 91.19 | 0.00 | 529.00 | 376.00 | 229.00 | 393.00
 | 0.02400
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
