YesidAlmanzaGamba/Thesis-Flight-Controller-Fixed-Wing/flight_tests/test_0_ML/csv_files/prueba1_transmision.csv

temperatura | altitud | presion | yaw | pitch | roll | compass | airSpeed | airTemperature | AirPressurePsi | latitud | longitud | tiempo | gpsSpeed | gpsTime
2.50 | 260.70 | 74.76 | 358.56 | -0.75 | 2.94 | 9.40 | 0.00 | 19.08 | 0.00 | 0.000000 | 0.000000
 | 0 | 0 | 0 | 0 | 0 | 8.00 | 8.61 | 896.49 | 257.11 | 357.75 | -0.88 | 3.12 | 25.09 | 0.00 | 19.08 | 0.00 | 0.000000 | 0.000000
 | 0 | 0 | 0 | 0 | 0 | 8.00 | 11.73 | 1221.44 | 350.31 | 355.87 | -1.00 | 3.12 | 28.29 | 0.00 | 19.08 | 0.00 | 0.000000 | 0.000000
 | 365 | 365 | 229 | 393 | 0 | 8.00 | 15.33 | 1596.92 | 457.98 | 355.62 | -0.94 | 3.00 | 29.09 | 0.00 | 19.08 | 0.00 | 0.000000 | 0.000000
 | 393 | 357 | 229 | 393 | 0 | 9.00 | 17.18 | 1788.81 | 513.01 | 355.62 | -0.88 | 2.94 | 29.47 | 0.00 | 19.08 | 0.00 | 0.000000 | 0.000000
 | 393 | 357 | 229 | 393 | 0 | 9.00 | 18.67 | 1944.21 | 557.59 | 355.62 | -0.88 | 2.94 | 29.11 | 0.00 | 19.08 | 0.00 | 0.000000 | 0.000000
 | 393 | 357 | 229 | 393 | 0 | 9.00 | 19.88 | 2070.11 | 593.69 | 355.62 | -0.94 | 3.00 | 29.32 | 0.00 | 19.08 | 0.00 | 0.000000 | 0.000000
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
