YesidAlmanzaGamba/Thesis-Flight-Controller-Fixed-Wing/flight_tests/test_0_ML/csv_files/recepcion.csv

Tiempo | Latitud | Longitud | Altitud | Velocidad del aire | Presión | Yaw | Pitch | Roll | Presion del aire(PSI) | serv0 | serv1 | serv2 | serv3
3 | 0.000000 | 379.000000 | 376.00 | 229.00 | 393.00 | 881.00 | 1.61 | 1.57 | 0.00 | 0.00 | 2606.79 | 0.00 | 747.63
 | 0.26475
0 | 0.000000 | 379.000000 | 376.00 | 229.00 | 393.00 | 881.00 | 1.61 | 1.57 | 0.00 | 0.00 | 2606.79 | 0.00 | 747.63
 | 0.26475
0 | 0.000000 | 379.000000 | 376.00 | 229.00 | 393.00 | 881.00 | 1.61 | 1.57 | 0.00 | 0.00 | 2606.79 | 0.00 | 747.63
 | 0.26475
0 | 0.000000 | 379.000000 | 376.00 | 229.00 | 393.00 | 881.00 | 1.61 | 1.57 | 0.00 | 0.00 | 2606.79 | 0.00 | 747.63
 | 0.26475
0 | 0.000000 | 379.000000 | 376.00 | 229.00 | 393.00 | 881.00 | 1.61 | 1.57 | 0.00 | 0.00 | 2606.79 | 0.00 | 747.63
 | 0.26475
0 | 0.000000 | 379.000000 | 376.00 | 229.00 | 393.00 | 881.00 | 1.61 | 1.57 | 0.00 | 0.00 | 2606.79 | 0.00 | 747.63
 | 0.26475
0 | 0.000000 | 379.000000 | 376.00 | 229.00 | 393.00 | 881.00 | 1.61 | 1.57 | 0.00 | 0.00 | 2606.79 | 0.00 | 747.63
 | 0.26475
0 | 0.000000 | 379.000000 | 376.00 | 229.00 | 393.00 | 881.00 | 1.61 | 1.57 | 0.00 | 0.00 | 2606.79 | 0.00 | 747.63
 | 0.26475
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
