YesidAlmanzaGamba/Thesis-Flight-Controller-Fixed-Wing/flight_tests/test_1/cvs_files/avion.csv

temperatura | altitud | presion | yaw | pitch | roll | compass | airSpeed | airTemperature | AirPressurePsi | latitud | longitud
2.01 | 261.19 | 74.71 | 121.31 | 0.00 | 0.00 | 315.10 | 0.00 | 15.95 | 0.00 | 0.000000 | 0.000000
 | 0 | 0 | 0 | 0 | 0 | 0.00 | 0.00 | 0.00
6.90 | 898.23 | 256.94 | 121.31 | 0.00 | 0.00 | 246.57 | 0.00 | 15.95 | 0.00 | 0.000000 | 0.000000
 | 0 | 0 | 0 | 0 | 0 | 0.00 | 0.00 | 0.00
10.47 | 1362.68 | 389.78 | 121.31 | 0.00 | 0.00 | 223.15 | 0.00 | 15.95 | 0.00 | 0.000000 | 0.000000
 | 0 | 0 | 0 | 0 | 0 | 0.00 | 0.00 | 0.00
13.07 | 1701.29 | 486.62 | 121.31 | 0.00 | 0.00 | 215.04 | 0.00 | 15.95 | 0.00 | 0.000000 | 0.000000
 | 0 | 0 | 0 | 0 | 0 | 0.00 | 0.00 | 0.00
14.40 | 1874.35 | 536.12 | 121.31 | 0.00 | 0.00 | 212.81 | 0.00 | 15.95 | 0.00 | 0.000000 | 0.000000
 | 0 | 0 | 0 | 0 | 0 | 0.00 | 0.00 | 0.00
15.94 | 2074.28 | 593.30 | 121.31 | 0.00 | 0.00 | 211.18 | 0.00 | 15.95 | 0.00 | 0.000000 | 0.000000
 | 0 | 0 | 0 | 0 | 0 | 0.00 | 0.00 | 0.00
17.06 | 2220.02 | 634.99 | 121.31 | 0.00 | 0.00 | 210.05 | 0.00 | 15.95 | 0.00 | 0.000000 | 0.000000
 | 0 | 0 | 0 | 0 | 0 | 0.00 | 0.00 | 0.00
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
