YesidAlmanzaGamba/Thesis-Flight-Controller-Fixed-Wing/flight_tests/test_1/cvs_files/transmision.csv

temperatura | altitud | presion | yaw | pitch | roll | compass | airSpeed | airTemperature | AirPressurePsi | latitud | longitud | servo0 | servo1 | servo2 | servo3 | servo4
 | xd
1.86 | 256.52 | 75.16 | 359.69 | 0.75 | 3.00 | 30.18 | 0.00 | 0.00 | 0.00 | 0.000000 | 0.000000 | 393 | 379 | 229 | 393 | 0 | 3.00
3.54 | 487.34 | 142.80 | 359.62 | 0.62 | 3.06 | 51.40 | 0.00 | 0.00 | 0.00 | 0.000000 | 0.000000 | 393 | 379 | 229 | 393 | 0 | 3.00
6.41 | 882.06 | 258.47 | 359.94 | 0.69 | 2.94 | 77.41 | 0.00 | 0.00 | 0.00 | 0.000000 | 0.000000 | 393 | 379 | 229 | 393 | 0 | 3.00
8.73 | 1201.78 | 352.16 | 359.81 | 0.50 | 3.19 | 89.65 | 0.00 | 0.00 | 0.00 | 0.000000 | 0.000000 | 395 | 379 | 229 | 393 | 0 | 3.00
9.72 | 1338.08 | 392.10 | 359.94 | 0.50 | 3.12 | 93.15 | 0.00 | 0.00 | 0.00 | 0.000000 | 0.000000 | 393 | 379 | 229 | 393 | 0 | 3.00
11.41 | 1571.20 | 460.40 | 0.19 | 0.62 | 2.94 | 97.42 | 0.00 | 0.00 | 0.00 | 0.000000 | 0.000000 | 393 | 379 | 229 | 393 | 0 | 3.00
12.78 | 1760.04 | 515.72 | 359.75 | 0.37 | 3.25 | 99.93 | 0.00 | 0.00 | 0.00 | 0.000000 | 0.000000 | 395 | 379 | 229 | 393 | 0 | 3.00
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
