YesidAlmanzaGamba/Thesis-Flight-Controller-Fixed-Wing/flight_tests/test_1/cvs_files/transmision_1.csv

temperatura | altitud | presion | yaw | pitch | roll | compass | airSpeed | airTemperature | AirPressurePsi | latitud | longitud | servo0 | servo1 | servo2 | servo3 | servo4 | tiempo_enviado | xd
18.58 | 2556.04 | 749.06 | 0.31 | 1.25 | 3.31 | 104.03 | 0.00 | 0.00 | 0.00 | 4.846313 | -74.159660 | 395 | 382 | 229 | 393 | 0 | 8.00
18.60 | 2557.66 | 749.54 | 0.31 | 1.12 | 3.19 | 102.96 | 0.00 | 0.00 | 0.00 | 4.846313 | -74.159660 | 395 | 382 | 229 | 393 | 0 | 8.00
18.61 | 2558.98 | 749.93 | 0.44 | 0.75 | 3.31 | 103.57 | 0.00 | 0.00 | 0.00 | 4.846312 | -74.159660 | 395 | 379 | 229 | 393 | 0 | 8.00
18.61 | 2560.00 | 750.26 | 0.44 | 0.69 | 3.37 | 103.44 | 0.00 | 0.00 | 0.00 | 4.846312 | -74.159660 | 395 | 379 | 229 | 393 | 0 | 8.00
18.62 | 2560.44 | 750.39 | 0.44 | 0.75 | 3.37 | 103.07 | 0.00 | 0.00 | 0.00 | 4.846312 | -74.159660 | 395 | 379 | 229 | 393 | 0 | 8.00
18.62 | 2560.84 | 750.52 | 0.56 | 0.62 | 3.37 | 103.50 | 0.00 | 0.00 | 0.00 | 4.846312 | -74.159660 | 6116 | 379 | 229 | -68 | 0 | 8.00
18.63 | 2561.57 | 750.72 | 0.44 | 0.75 | 3.44 | 103.34 | 0.00 | 0.00 | 0.00 | 4.846312 | -74.159660 | 2673 | 379 | 229 | 393 | 0 | 8.00
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
