YesidAlmanzaGamba/Thesis-Flight-Controller-Fixed-Wing/flight_tests/test_1/cvs_files/Recepcion/dataSaved_10.csv

Tiempo | Latitud | Longitud | Altitud | Velocidad del aire | Presión | Yaw | Pitch | Roll | Presion del aire(PSI) | serv0 | serv1 | serv2 | serv3
3 | 4.846300 | -74.159691 | 2564.30 | 0.00 | 751.64 | 181.00 | -3.44 | 11.00 | 0.00 | 480.00 | 379.00 | 229.00 | 393.00 | 510.00000
0 | 4.846300 | -74.159691 | 2564.30 | 0.00 | 751.64 | 181.00 | -3.44 | 11.00 | 0.00 | 480.00 | 379.00 | 229.00 | 393.00 | 510.00000
0 | 4.846300 | -74.159691 | 2564.30 | 0.00 | 751.64 | 181.00 | -3.44 | 11.00 | 0.00 | 480.00 | 379.00 | 229.00 | 393.00 | 510.00000
0 | 4.846300 | -74.159691 | 2564.30 | 0.00 | 751.64 | 181.00 | -3.44 | 11.00 | 0.00 | 480.00 | 379.00 | 229.00 | 393.00 | 510.00000
0 | 4.846300 | -74.159691 | 2564.30 | 0.00 | 751.64 | 181.00 | -3.44 | 11.00 | 0.00 | 480.00 | 379.00 | 229.00 | 393.00 | 510.00000
0 | 4.846300 | -74.159691 | 2564.30 | 0.00 | 751.64 | 181.00 | -3.44 | 11.00 | 0.00 | 480.00 | 379.00 | 229.00 | 393.00 | 510.00000
0 | 4.846300 | -74.159691 | 2564.30 | 0.00 | 751.64 | 181.00 | -3.44 | 11.00 | 0.00 | 480.00 | 379.00 | 229.00 | 393.00 | 510.00000
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
