YesidAlmanzaGamba/Thesis-Flight-Controller-Fixed-Wing/flight_tests/test_1/cvs_files/Recepcion/dataSaved_6.csv

Tiempo | Latitud | Longitud | Altitud | Velocidad del aire | Presión | Yaw | Pitch | Roll | Presion del aire(PSI) | serv0 | serv1 | serv2 | serv3
3 | 4.846305 | -74.159668 | 2568.51 | 0.00 | 751.24 | 353.19 | -0.44 | 2.31 | 0.00 | 387.00 | 379.00 | 229.00 | 393.00 | 183.00000
0 | 4.846305 | -74.159668 | 2568.52 | 0.00 | 751.24 | 353.12 | -0.44 | 2.94 | 0.00 | 393.00 | 379.00 | 229.00 | 393.00 | 185.00000
0 | 4.846305 | -74.159668 | 2568.52 | 0.00 | 751.24 | 353.12 | -0.44 | 2.94 | 0.00 | 393.00 | 379.00 | 229.00 | 393.00 | 185.00000
0 | 4.846305 | -74.159668 | 2568.51 | 0.00 | 751.24 | 353.00 | -0.44 | 3.06 | 0.00 | 393.00 | 379.00 | 229.00 | 393.00 | 185.00000
0 | 4.846305 | -74.159668 | 2568.49 | 0.00 | 751.24 | 353.00 | -0.44 | 3.06 | 0.00 | 393.00 | 379.00 | 229.00 | 393.00 | 185.00000
0 | 4.846305 | -74.159668 | 2568.47 | 0.00 | 751.24 | 353.00 | -0.44 | 3.06 | 0.00 | 393.00 | 379.00 | 229.00 | 393.00 | 185.00000
0 | 4.846305 | -74.159668 | 2568.47 | 0.00 | 751.24 | 353.00 | -0.44 | 3.06 | 0.00 | 393.00 | 379.00 | 229.00 | 393.00 | 185.00000
0 | 4.846305 | -74.159668 | 2568.51 | 0.00 | 751.24 | 353.06 | -0.44 | 3.00 | 0.00 | 393.00 | 379.00 | 229.00 | 393.00 | 185.00000
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
