YesidAlmanzaGamba/Thesis-Flight-Controller-Fixed-Wing/flight_tests/test_1/cvs_files/Recepcion/dataSaved_8.csv

Tiempo | Latitud | Longitud | Altitud | Velocidad del aire | Presión | Yaw | Pitch | Roll | Presion del aire(PSI) | serv0 | serv1 | serv2 | serv3
3 | 4.846283 | -74.159645 | 2565.04 | 0.00 | 751.57 | 8.50 | 0.25 | 3.62 | 0.00 | 398.00 | 379.00 | 229.00 | 393.00 | 294.00000
0 | 4.846283 | -74.159645 | 2565.04 | 0.00 | 751.57 | 8.50 | 0.25 | 3.62 | 0.00 | 398.00 | 379.00 | 229.00 | 393.00 | 294.00000
0 | 4.846284 | -74.159645 | 2565.04 | 0.00 | 751.57 | 8.75 | 0.56 | 3.19 | 0.00 | 395.00 | 379.00 | 229.00 | 393.00 | 295.00000
0 | 4.846284 | -74.159645 | 2565.05 | 0.00 | 751.57 | 8.81 | 0.56 | 3.19 | 0.00 | 395.00 | 379.00 | 229.00 | 393.00 | 295.00000
0 | 4.846284 | -74.159645 | 2565.07 | 0.00 | 751.56 | 8.81 | 0.56 | 3.19 | 0.00 | 395.00 | 379.00 | 229.00 | 393.00 | 295.00000
0 | 4.846284 | -74.159645 | 2565.07 | 0.00 | 751.56 | 8.81 | 0.56 | 3.19 | 0.00 | 395.00 | 379.00 | 229.00 | 393.00 | 295.00000
0 | 4.846284 | -74.159645 | 2565.11 | 0.00 | 751.56 | 8.81 | 0.56 | 3.19 | 0.00 | 395.00 | 379.00 | 229.00 | 393.00 | 295.00000
0 | 4.846284 | -74.159645 | 2565.15 | 0.00 | 751.56 | 8.81 | 0.56 | 3.19 | 0.00 | 395.00 | 379.00 | 229.00 | 393.00 | 296.00000
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
