YesidAlmanzaGamba/Thesis-Flight-Controller-Fixed-Wing/Documento/Imagenes/Pruebas/Comparación Pitch.png

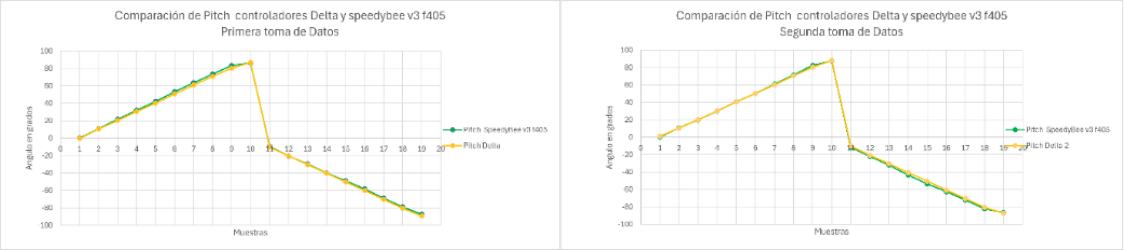
Documento/Imagenes/Pruebas/Comparación Pitch.png
