YesidAlmanzaGamba/Thesis-Flight-Controller-Fixed-Wing/Documento/Imagenes/Pruebas/Comparación Roll.png

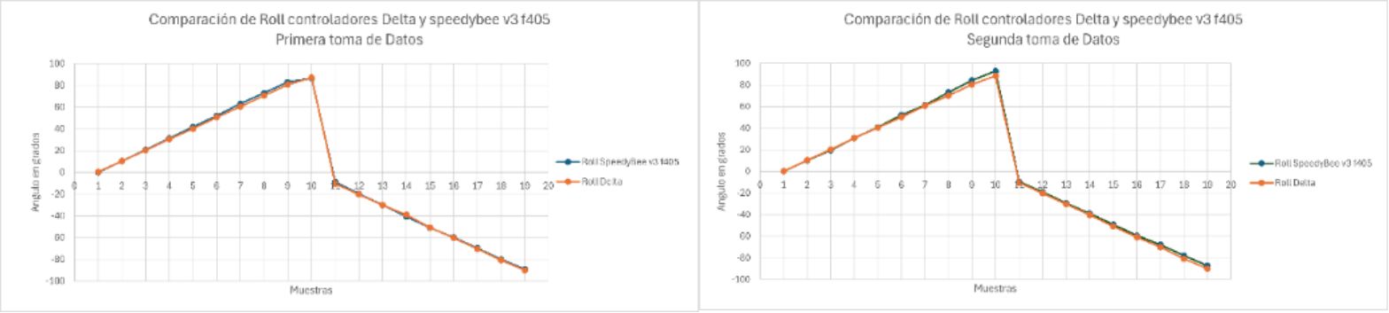
Documento/Imagenes/Pruebas/Comparación Roll.png
