YesidAlmanzaGamba/Thesis-Flight-Controller-Fixed-Wing/Documento/Imagenes/Pruebas/UAV protegé.png

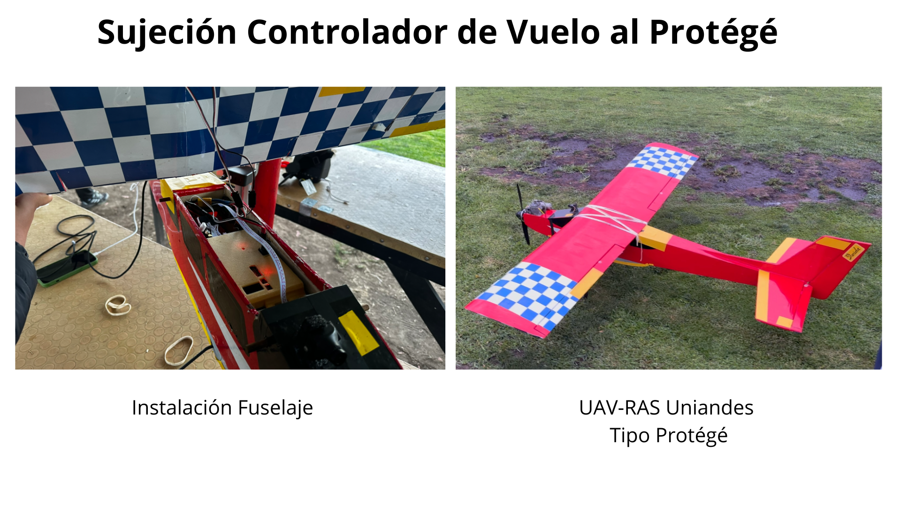
Documento/Imagenes/Pruebas/UAV protegé.png
