YesidAlmanzaGamba/Thesis-Flight-Controller-Fixed-Wing/flight_tests/test_1/graphs/BMP280_sensor.png

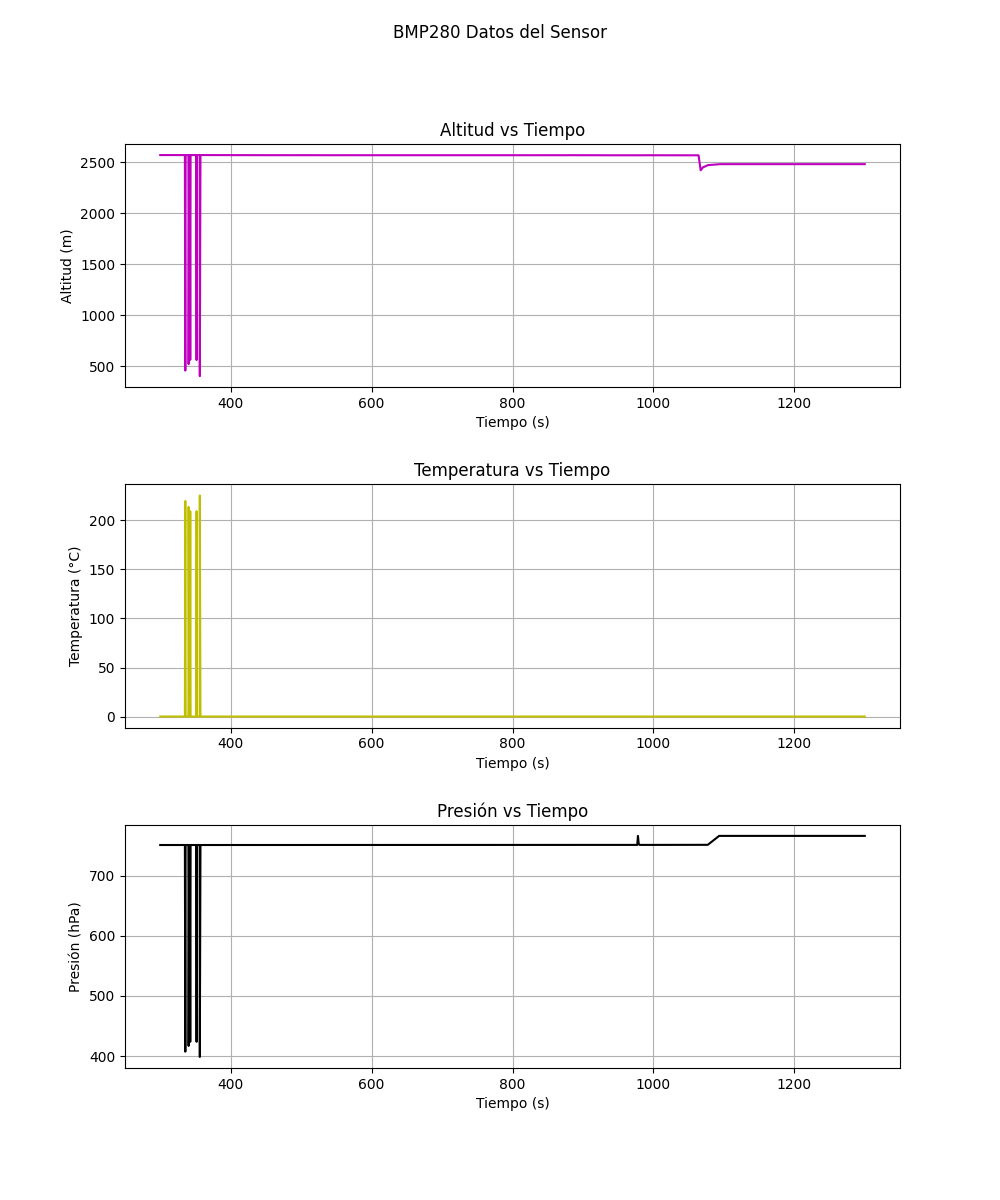
flight_tests/test_1/graphs/BMP280_sensor.png
