YesidAlmanzaGamba/Thesis-Flight-Controller-Fixed-Wing/flight_tests/test_1/graphs/BNO055_orientacion_recibidas.png

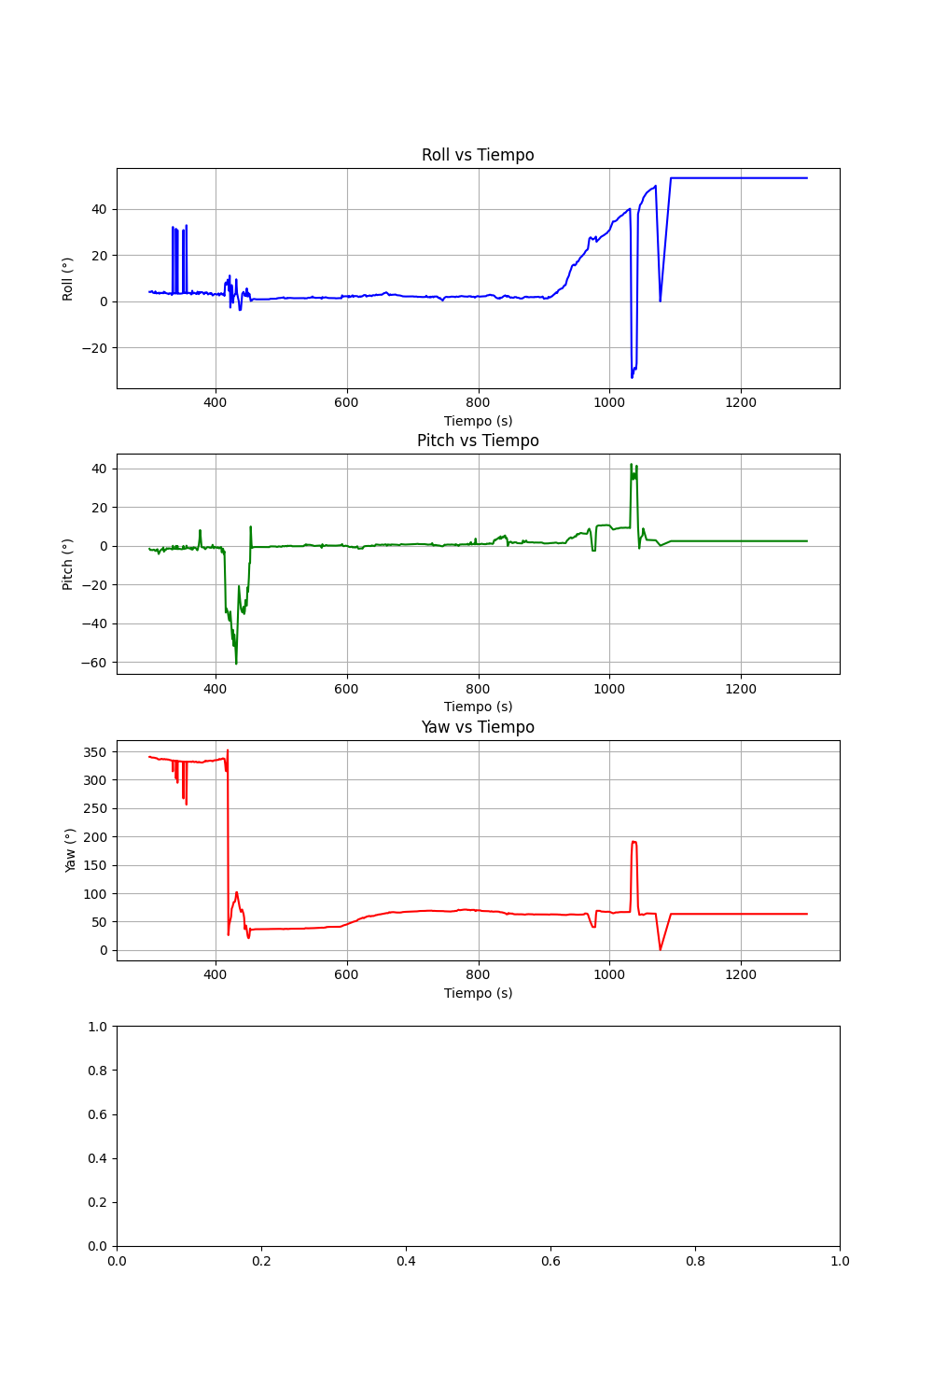
flight_tests/test_1/graphs/BNO055_orientacion_recibidas.png
