YesidAlmanzaGamba/Thesis-Flight-Controller-Fixed-Wing/flight_tests/test_1/graphs/combined_plot_interpolated.png

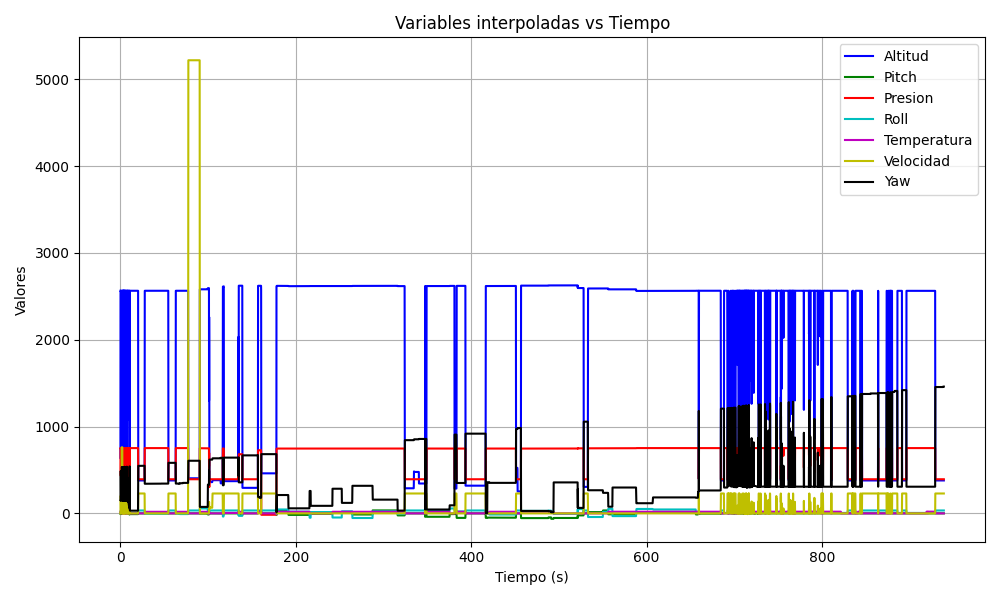
flight_tests/test_1/graphs/combined_plot_interpolated.png
