YesidAlmanzaGamba/Thesis-Flight-Controller-Fixed-Wing/flight_tests/test_1/graphs/comparison_subplots_smoothed.png

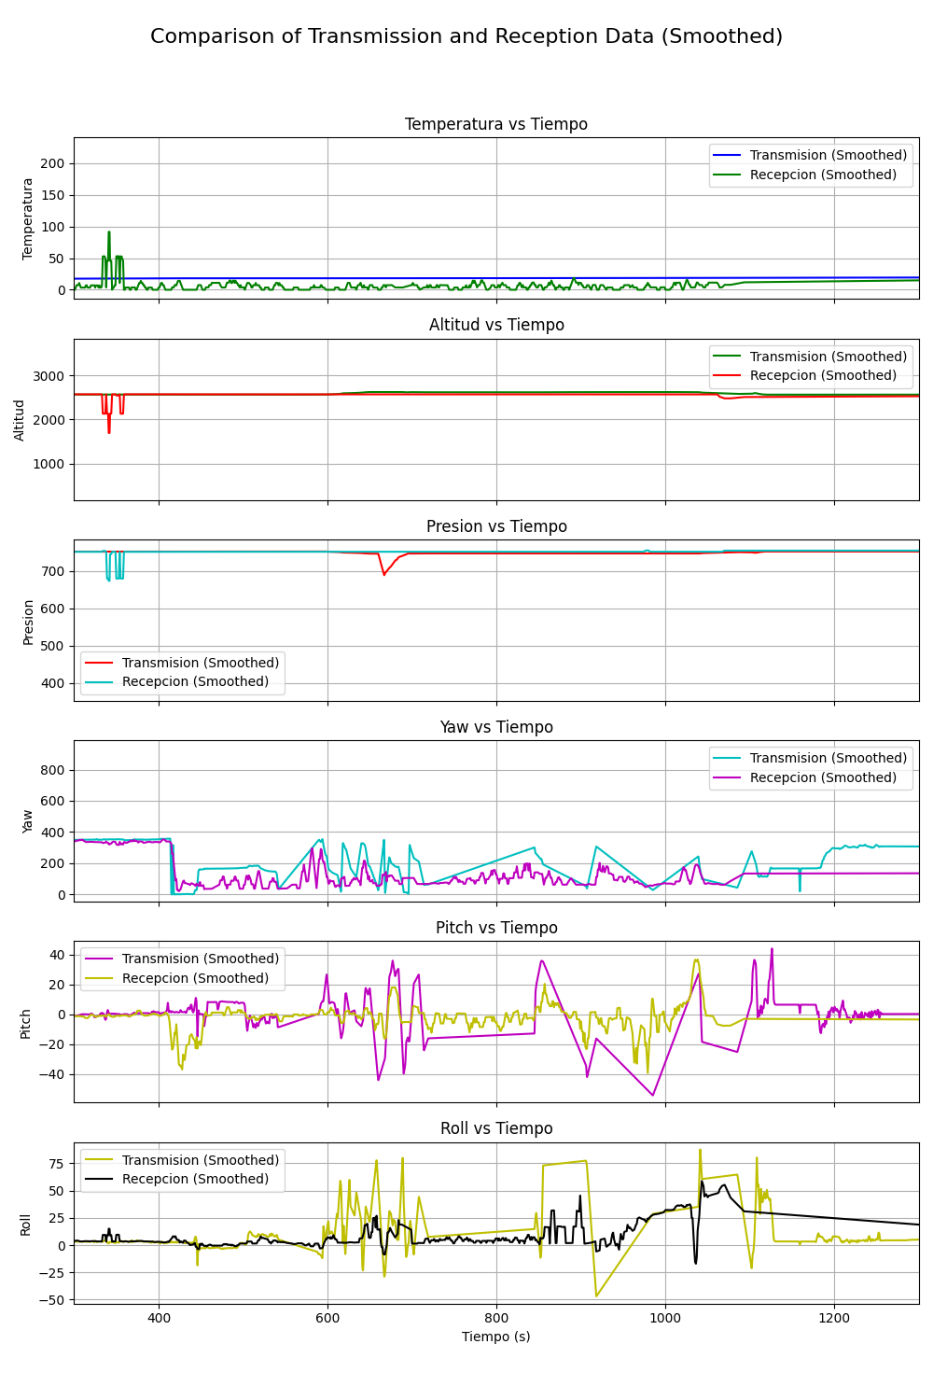
flight_tests/test_1/graphs/comparison_subplots_smoothed.png
