YesidAlmanzaGamba/Thesis-Flight-Controller-Fixed-Wing/flight_tests/test_1/graphs/pitch_vs_tiempo.png

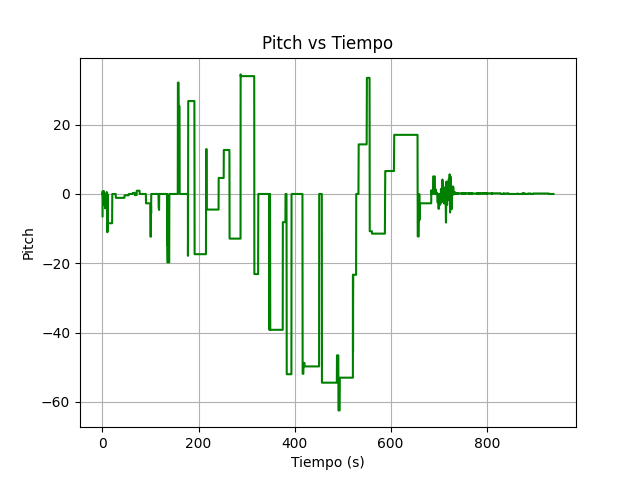
flight_tests/test_1/graphs/pitch_vs_tiempo.png
