YesidAlmanzaGamba/Thesis-Flight-Controller-Fixed-Wing/flight_tests/test_1/graphs/subplots_interpolated_filtered.png

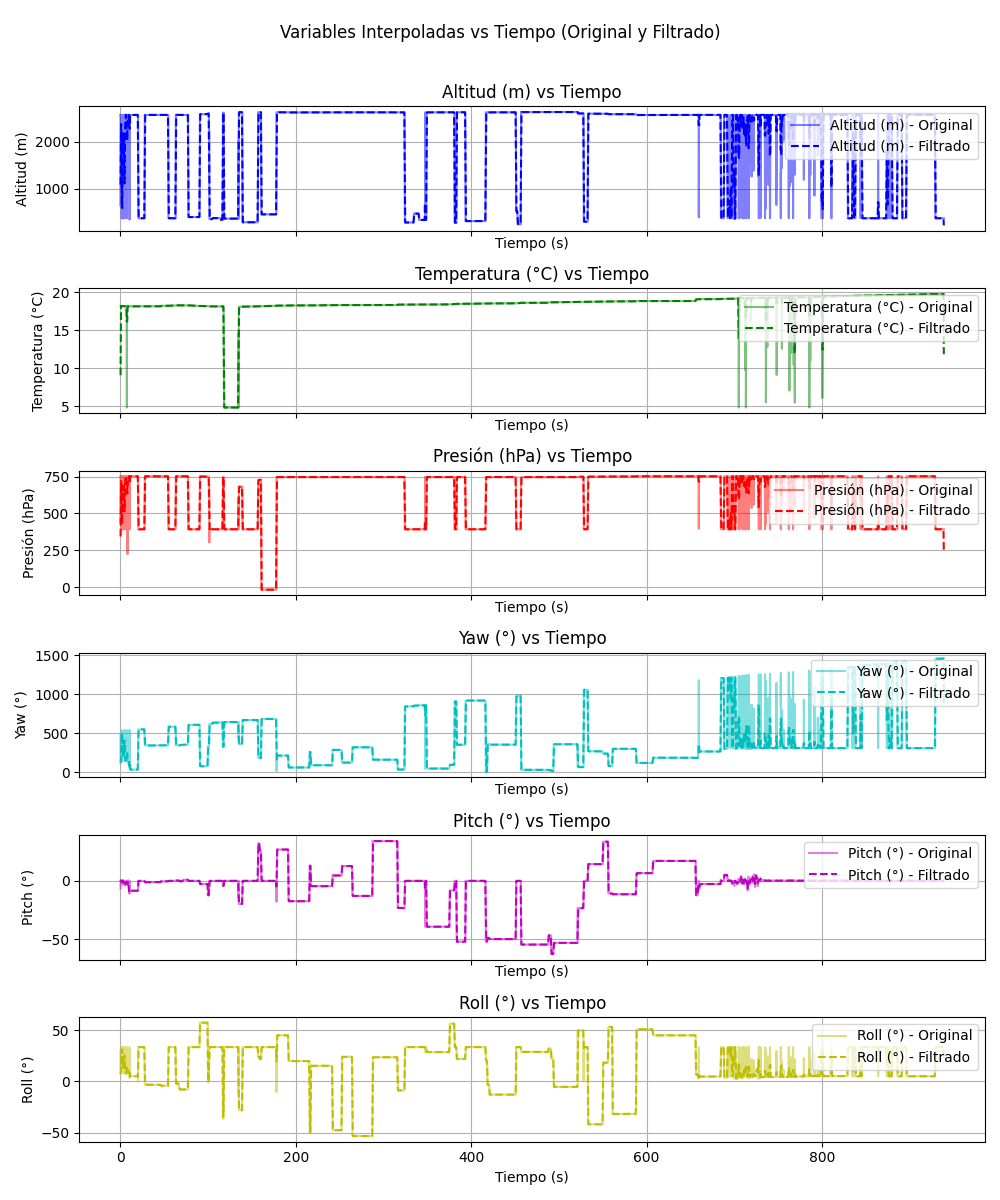
flight_tests/test_1/graphs/subplots_interpolated_filtered.png
