YesidAlmanzaGamba/Thesis-Flight-Controller-Fixed-Wing/flight_tests/test_1/graphs/temperatura_vs_tiempo.png

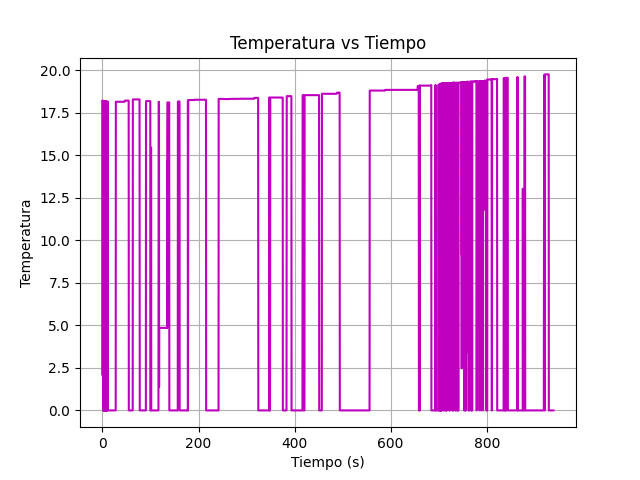
flight_tests/test_1/graphs/temperatura_vs_tiempo.png
