YesidAlmanzaGamba/Thesis-Flight-Controller-Fixed-Wing/flight_tests/test_1/graphs/velocidad_vs_tiempo_interfaz.png

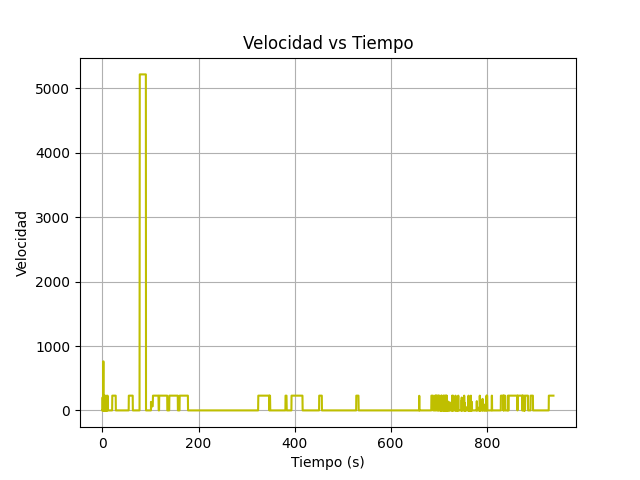
flight_tests/test_1/graphs/velocidad_vs_tiempo_interfaz.png
