YesidAlmanzaGamba/Thesis-Flight-Controller-Fixed-Wing/flight_tests/test_1/graphs/yaw_pitch_roll_vs_tiempo_recibidas.png

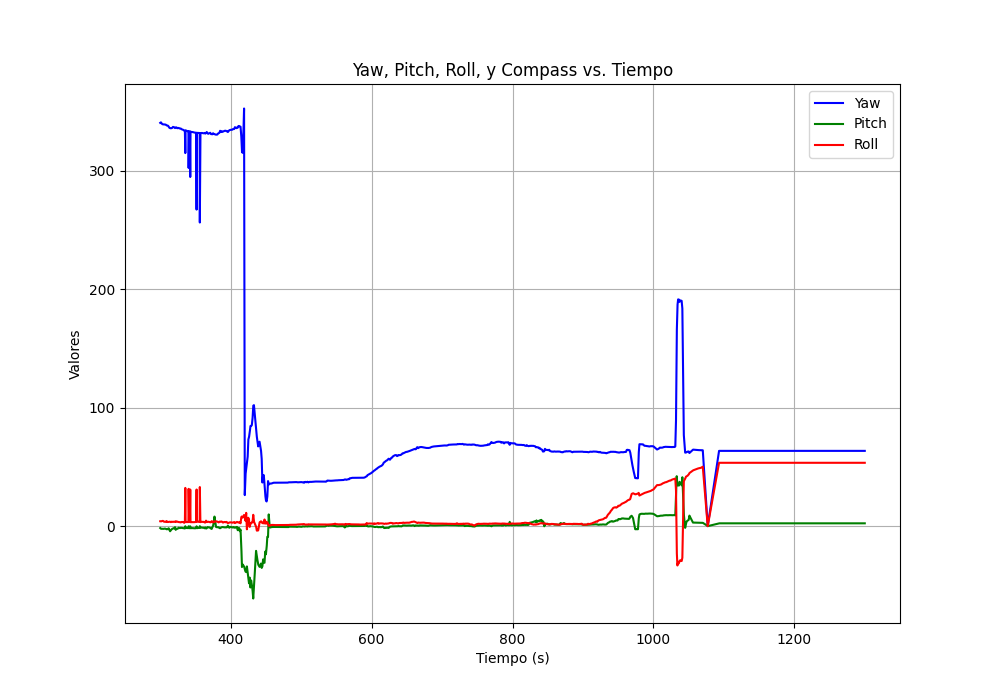
flight_tests/test_1/graphs/yaw_pitch_roll_vs_tiempo_recibidas.png
