YesidAlmanzaGamba/Thesis-Flight-Controller-Fixed-Wing/src/pcb/Delta 2.0/Esquematico.pdf

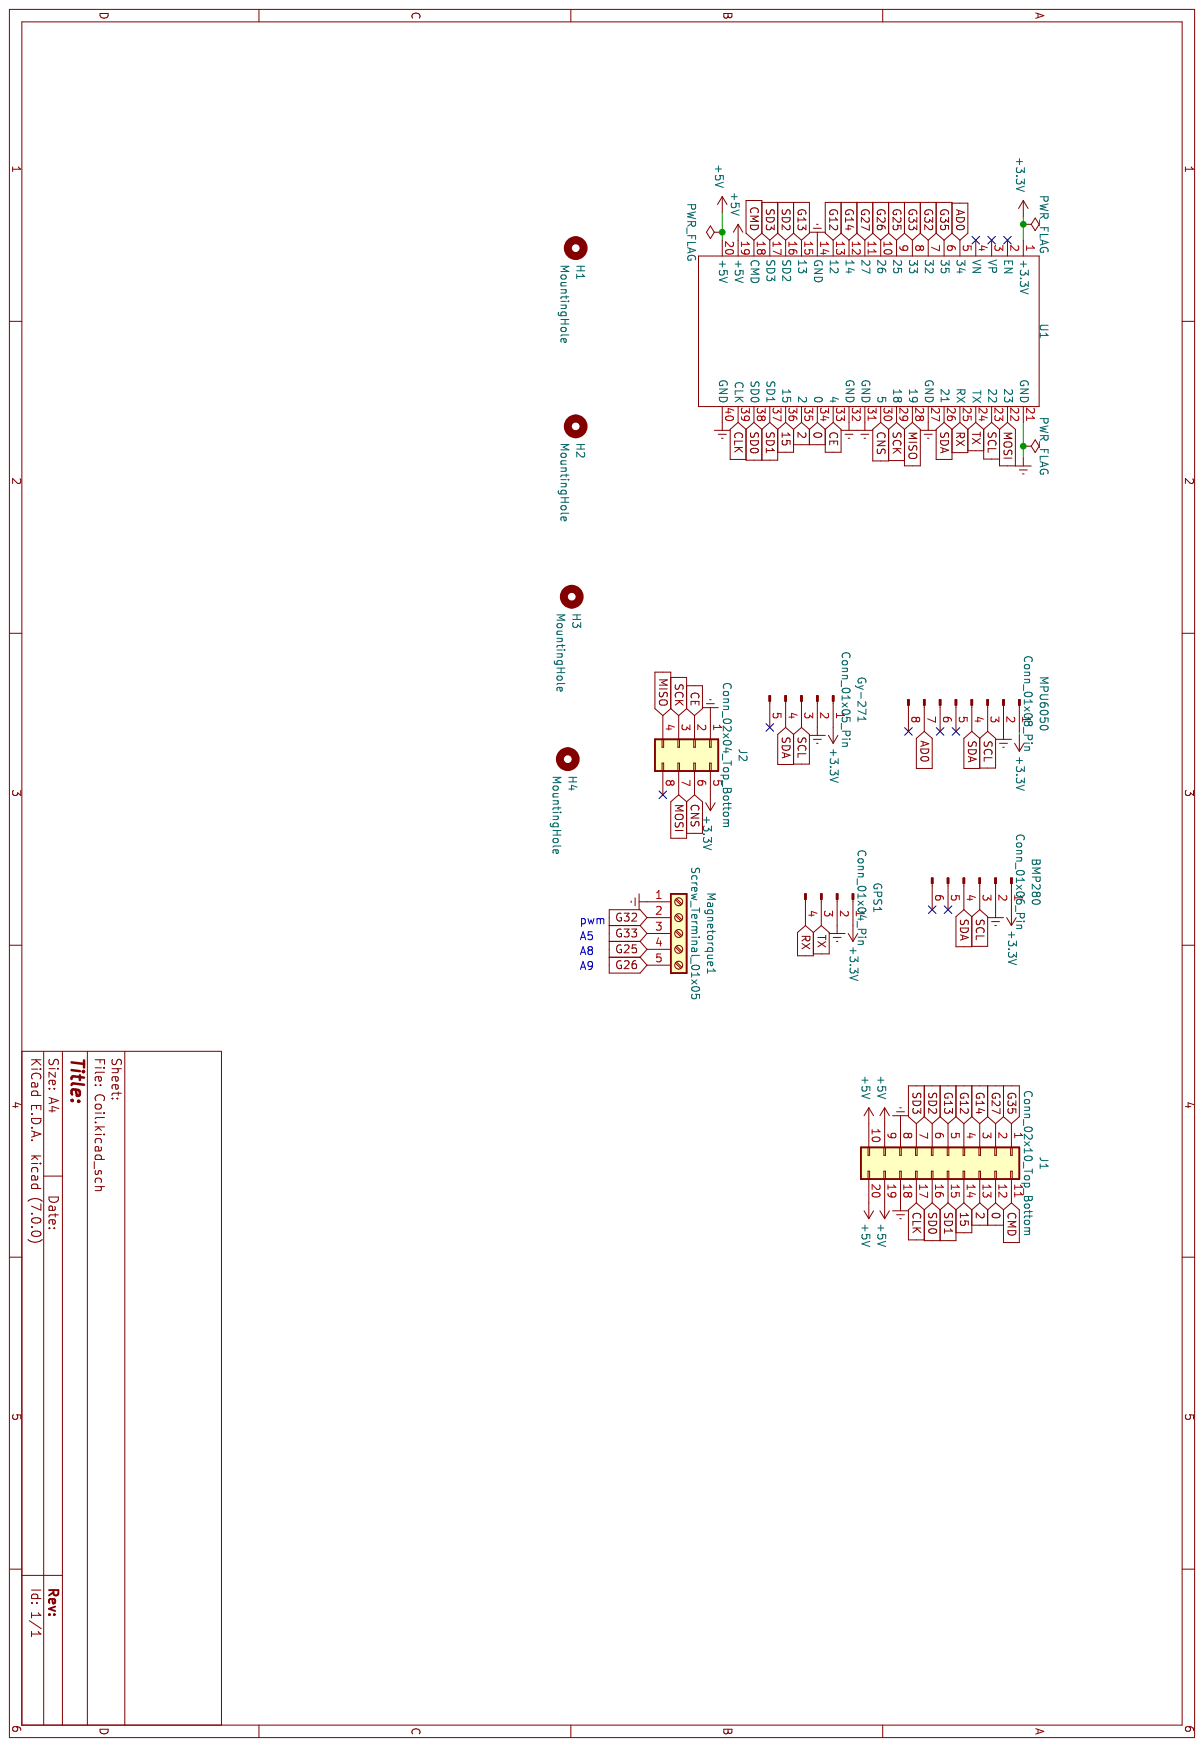
[picture p160: page 1]
