YesidAlmanzaGamba/Thesis-Flight-Controller-Fixed-Wing/src/pcb/Delta 2.0/C1.kicad_pcb

## KiCad design src/pcb/Delta 2.0/C1.kicad_pcb (2024-11-07)

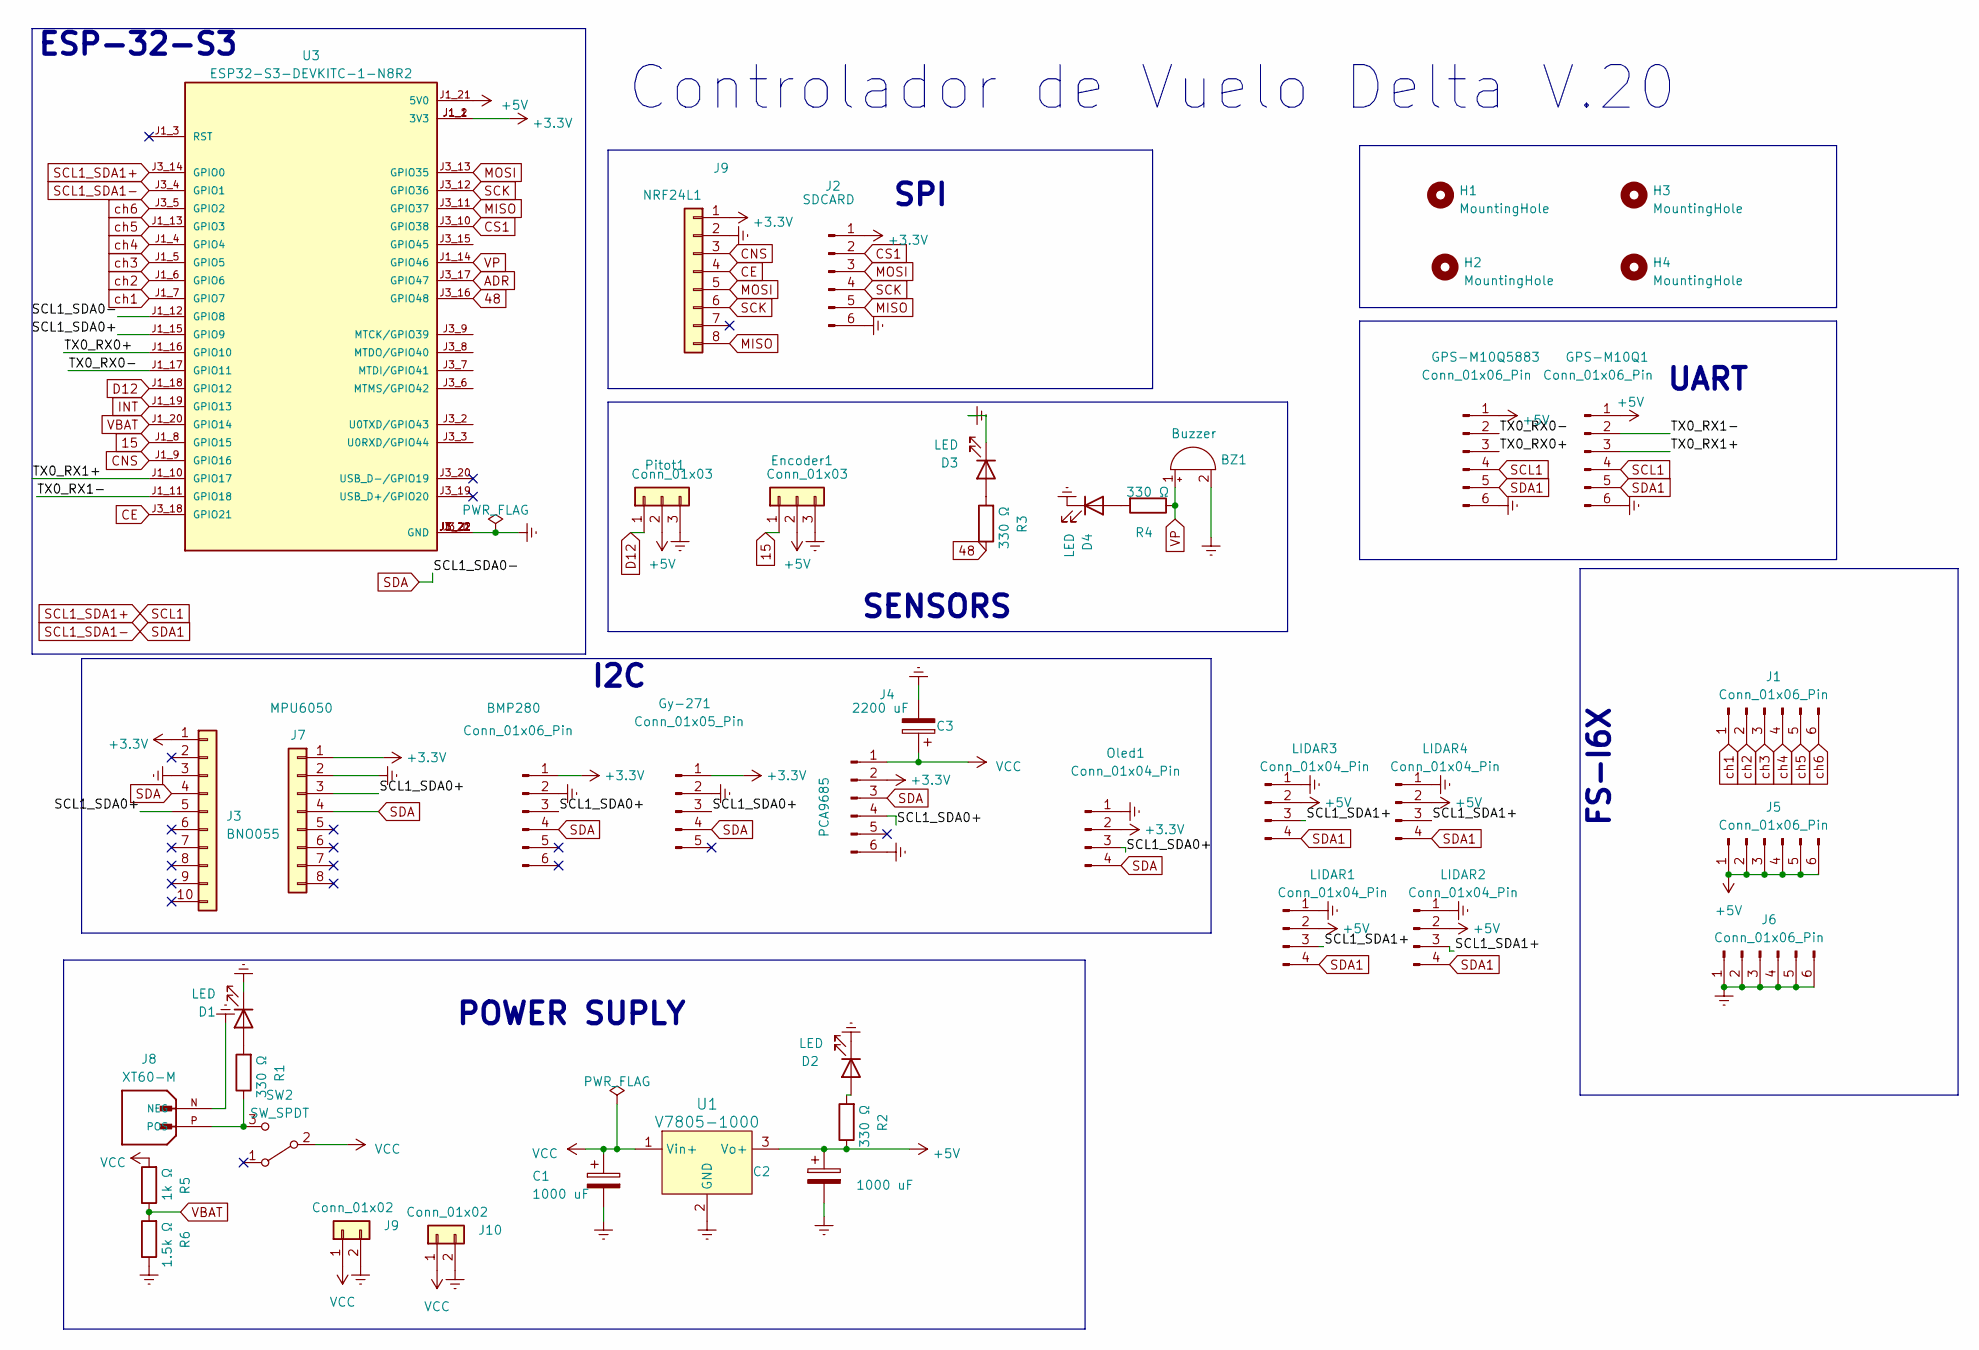
[picture p161: schematic C1.kicad_sch]

Parts:
BMP280: Conn_01x06_Pin; module_bme280
BZ1: Buzzer; Buzzer_15x7.5RM7.6
C1, C2: 1000 uF; CP_Elec_10x12.6
C3: 2200 uF; CP_Elec_10x12.6
D1, D2, D3, D4: LED; LED_0402_1005Metric
Encoder1: Conn_01x03; JST_EH_B3B-EH-A_1x03_P2.50mm_Vertical
GPS-M10Q1, GPS-M10Q5883: Conn_01x06_Pin; JST_EH_B6B-EH-A_1x06_P2.50mm_Vertical
Gy-271: Conn_01x05_Pin; Hmc5883l Gy271
H1, H2, H3, H4: MountingHole; MountingHole_3mm_Pad
J1, J5, J6: Conn_01x06_Pin; JST_EH_B6B-EH-A_1x06_P2.50mm_Vertical
J2: SDCARD; PinSocket_1x06_P2.54mm_Vertical
J3: BNO055
J4: PCA9685; PCA 9685
J7: MPU6050; module_mpu6050
J8: XT60-M; AMASS_XT60-M; PARTREV V1.2
J9, J10: Conn_01x02; JST_EH_B2B-EH-A_1x02_P2.50mm_Vertical
LIDAR1, LIDAR2, LIDAR3, LIDAR4: Conn_01x04_Pin; JST_EH_B4B-EH-A_1x04_P2.50mm_Vertical
NRF24L1: J9; PinSocket_2x04_P2.54mm_Vertical
Oled1: Conn_01x04_Pin; OLED
Pitot1: Conn_01x03; JST_EH_B3B-EH-A_1x03_P2.50mm_Vertical
R1, R2: 330 Ω; R_0603_1608Metric
R3, R4: 330 Ω; R_0805_2012Metric
R5: 1k Ω; R_0603_1608Metric
R6: 1.5k Ω; R_0603_1608Metric
SW2: SW_SPDT; Switch_Slide
U1: V7805-1000; 3-SIP_Module_V7805-1000; MPN V7805-1000; Digi-Key_PN 102-1715-ND
U3: ESP32-S3-DEVKITC-1-N8R2; XCVR_ESP32-S3-DEVKITC-1-N8R2; PARTREV V1

Connections:
15: Encoder1.1, U3.J1_8 (GPIO15)
48: R3.1, U3.J3_16 (GPIO48)
+3.3V: BMP280.1, Gy-271.1, J2.1, J3.1, J4.2, J7.1, NRF24L1.1, Oled1.2, U3.J1_1 (3V3), U3.J1_2 (3V3)
+5V: C2.1, Encoder1.2, GPS-M10Q1.1, GPS-M10Q5883.1, J5.1, J5.2, J5.3, J5.4, J5.5, J5.6, LIDAR1.2, LIDAR2.2, LIDAR3.2, LIDAR4.2, Pitot1.2, R2.1, U1.3 (Vo+), U3.J1_21 (5V0)
/SCL1_SDA0+: BMP280.3, Gy-271.3, J3.5, J4.4, J7.3, Oled1.3, U3.J1_15 (GPIO9)
/TX0_RX0+: GPS-M10Q5883.3, U3.J1_16 (GPIO10)
/TX0_RX0-: GPS-M10Q5883.2, U3.J1_17 (GPIO11)
/TX0_RX1+: GPS-M10Q1.3, U3.J1_10 (GPIO17)
/TX0_RX1-: GPS-M10Q1.2, U3.J1_11 (GPIO18)
ADR: U3.J3_17 (GPIO47)
CE: NRF24L1.4, U3.J3_18 (GPIO21)
CNS: NRF24L1.3, U3.J1_9 (GPIO16)
CS1: J2.2, U3.J3_10 (GPIO38)
D12: Pitot1.1, U3.J1_18 (GPIO12)
Earth: BMP280.2, BZ1.2 (+), C1.2, C2.2, C3.2, D1.1 (K), D2.1 (K), D3.1 (K), D4.1 (K), Encoder1.3, GPS-M10Q1.6, GPS-M10Q5883.6, Gy-271.2, J2.6, J3.3, J4.6, J6.1, J6.2, J6.3, J6.4, J6.5, J6.6, J7.2, J8.N (NEG), J9.2, J10.2, LIDAR1.1, LIDAR2.1, LIDAR3.1, LIDAR4.1, NRF24L1.2, Oled1.1, Pitot1.3, R6.1, U1.2 (GND), U3.J1_22 (GND), U3.J3_1 (GND), U3.J3_21 (GND), U3.J3_22 (GND)
INT: U3.J1_19 (GPIO13)
MISO: J2.5, NRF24L1.8, U3.J3_11 (GPIO37)
MOSI: J2.3, NRF24L1.5, U3.J3_13 (GPIO35)
unnamed: D1.2 (A), R1.2
unnamed: D2.2 (A), R2.2
unnamed: D3.2 (A), R3.2
unnamed: D4.2 (A), R4.2
unnamed: J8.P (POS), R1.1, SW2.3 (C)
SCK: J2.4, NRF24L1.6, U3.J3_12 (GPIO36)
SCL1: GPS-M10Q1.4, GPS-M10Q5883.4, LIDAR1.3, LIDAR2.3, LIDAR3.3, LIDAR4.3, U3.J3_14 (GPIO0)
SCL1_SDA1-: GPS-M10Q1.5, GPS-M10Q5883.5, LIDAR1.4, LIDAR2.4, LIDAR3.4, LIDAR4.4, U3.J3_4 (GPIO1)
SDA: BMP280.4, Gy-271.4, J3.4, J4.3, J7.4, Oled1.4, U3.J1_12 (GPIO8)
VBAT: R5.1, R6.2, U3.J1_20 (GPIO14)
VCC: C1.1, C3.1, J4.1, J9.1, J10.1, R5.2, SW2.2 (B), U1.1 (Vin+)
VP: BZ1.1 (-), R4.1, U3.J1_14 (GPIO46)
ch1: J1.1, U3.J1_7 (GPIO7)
ch2: J1.2, U3.J1_6 (GPIO6)
ch3: J1.3, U3.J1_5 (GPIO5)
ch4: J1.4, U3.J1_4 (GPIO4)
ch5: J1.5, U3.J1_13 (GPIO3)
ch6: J1.6, U3.J3_5 (GPIO2)

Notes on the sheet:
I2C
UART
POWER SUPLY
SENSORS
FS-I6X
SPI
Controlador de Vuelo Delta V.20
ESP-32-S3

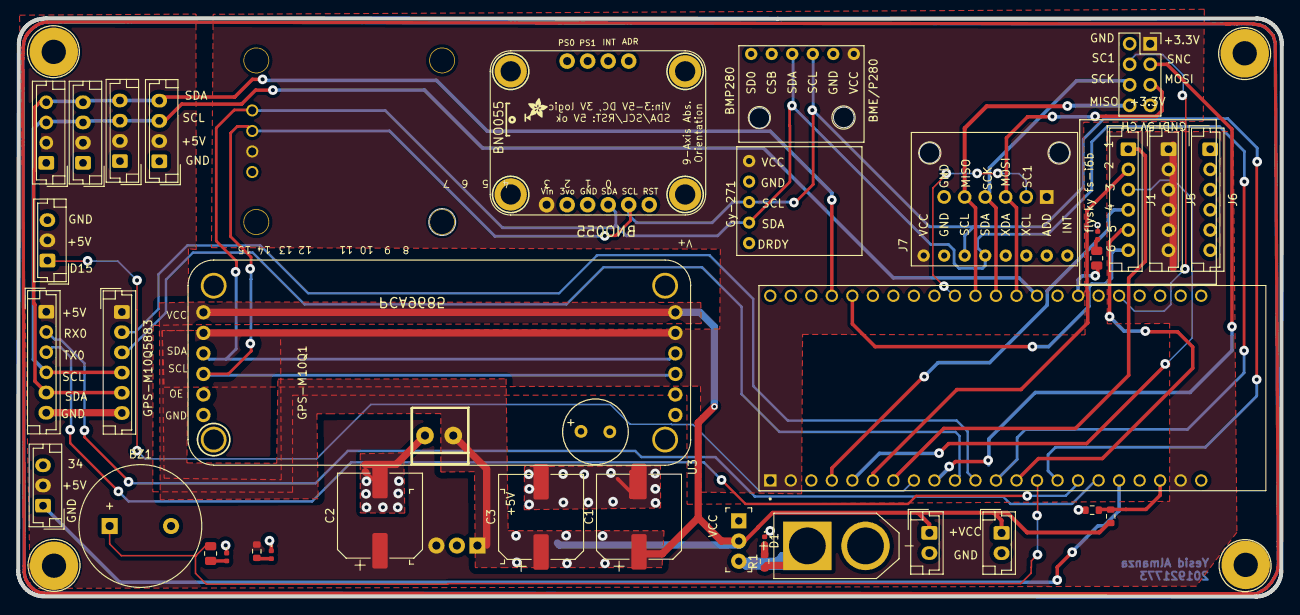
[picture p162: board src/pcb/Delta 2.0/C1.kicad_pcb from above]

Board: 2 copper layers, 156.4 x 71.6 mm, 43 parts (1 on the bottom side), 34 nets.
