YesidAlmanzaGamba/Thesis-Flight-Controller-Fixed-Wing/src/pcb/DELTA 1.0/C1/C1.kicad_pcb

## KiCad design src/pcb/DELTA 1.0/C1/C1.kicad_pcb (2024-11-01)

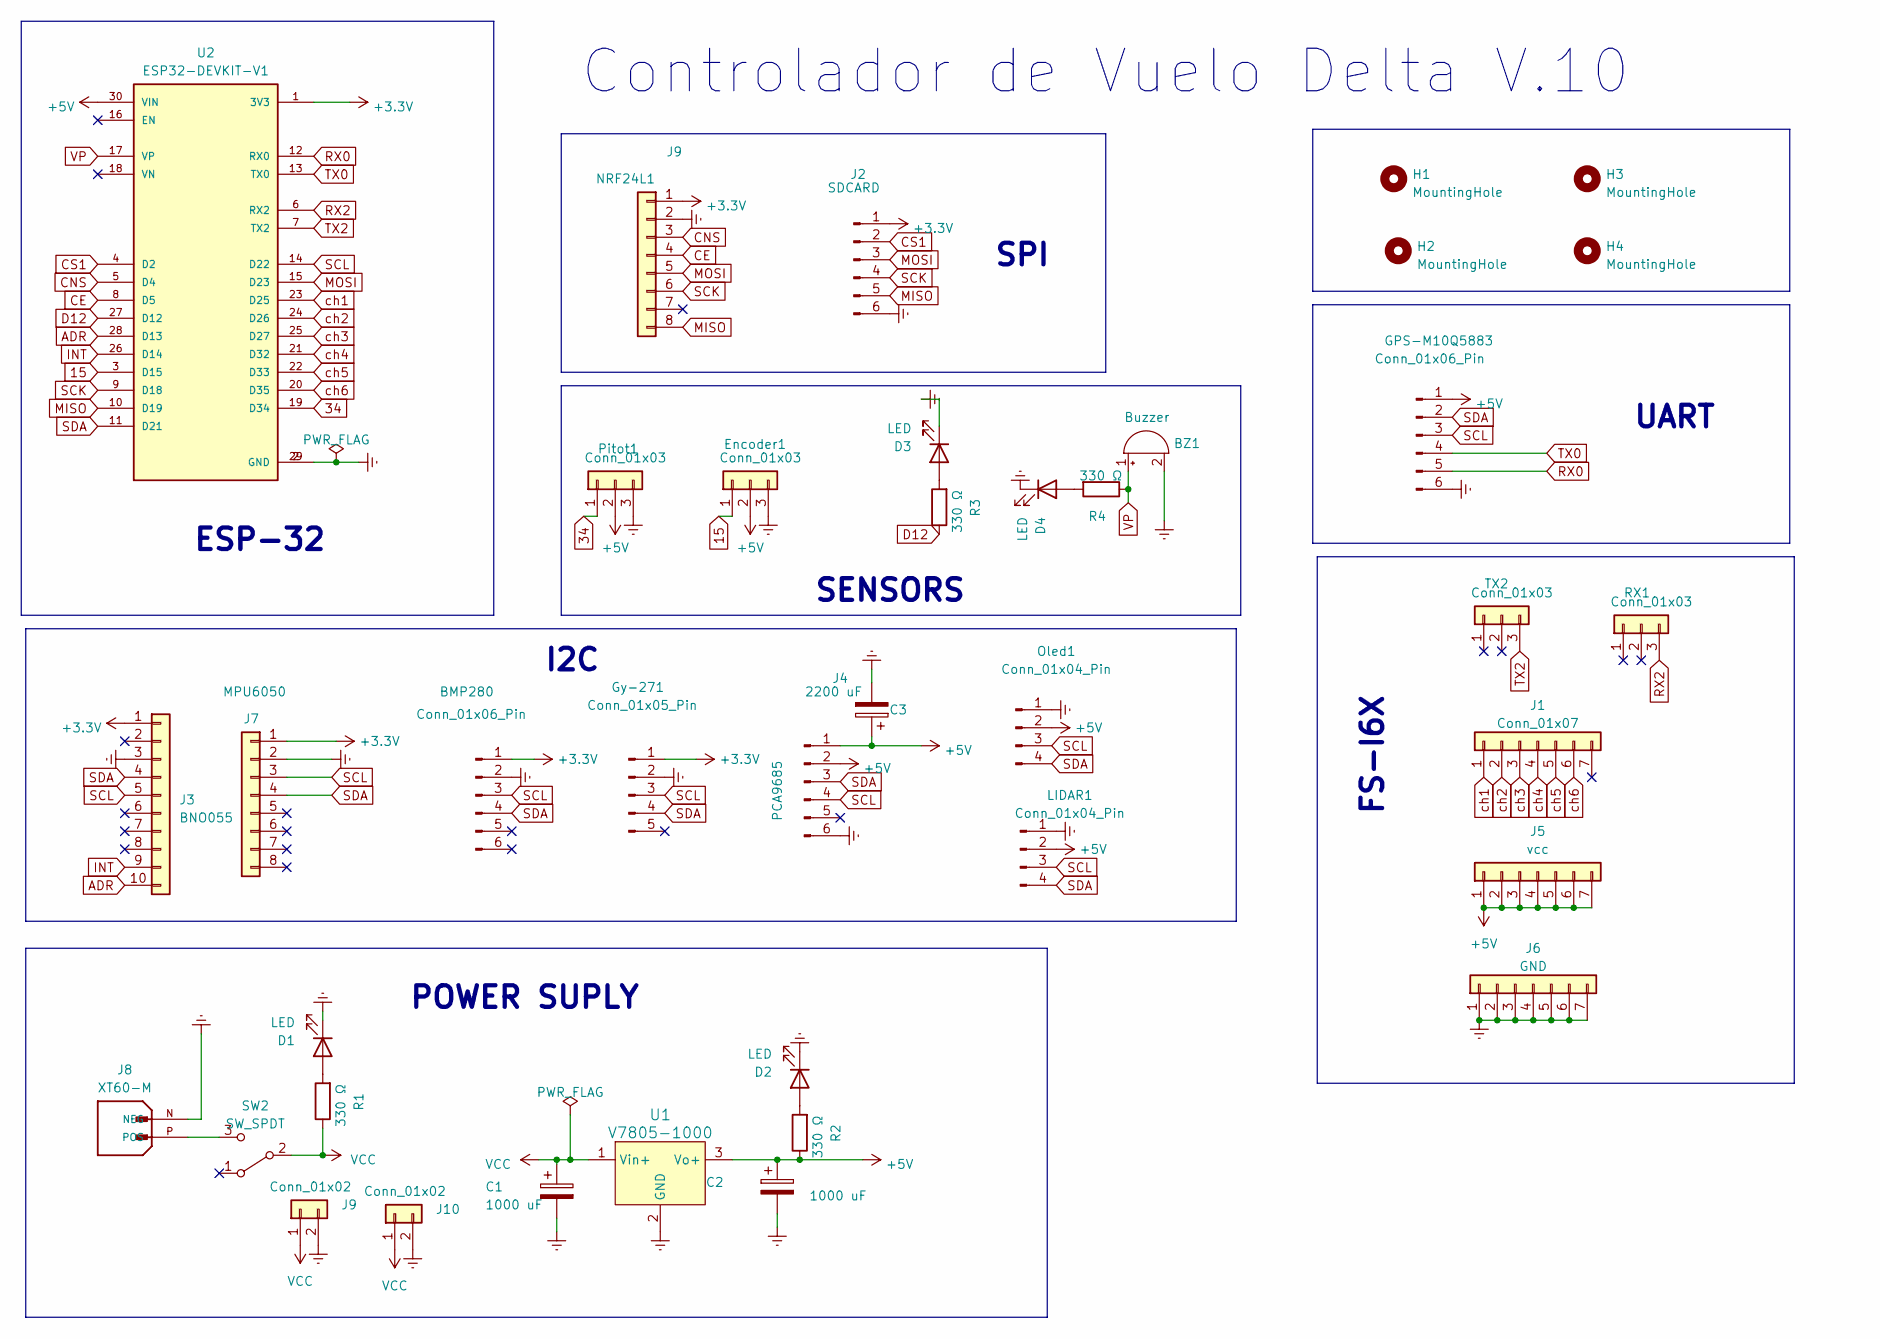
[picture p163: schematic C1.kicad_sch]

Parts:
BMP280: Conn_01x06_Pin; module_bme280
BZ1: Buzzer; Buzzer_15x7.5RM7.6
C1, C2: 1000 uF; CP_Radial_D8.0mm_P3.50mm
C3: 2200 uF; CP_Radial_D8.0mm_P3.50mm
D1, D2, D3, D4: LED; LED_1206_3216Metric
Encoder1: Conn_01x03; PinHeader_1x03_P2.54mm_Vertical
GPS-M10Q5883: Conn_01x06_Pin; JST_EH_B6B-EH-A_1x06_P2.50mm_Vertical
Gy-271: Conn_01x05_Pin; Hmc5883l Gy271
H1, H2, H3, H4: MountingHole; MountingHole_3mm_Pad
J1: Conn_01x07; PinHeader_1x07_P2.54mm_Vertical
J2: SDCARD; PinSocket_1x06_P2.54mm_Vertical
J3: BNO055
J4: PCA9685; PCA 9685
J5: vcc; PinHeader_1x07_P2.54mm_Vertical
J6: GND; PinHeader_1x07_P2.54mm_Vertical
J7: MPU6050; module_mpu6050
J8: XT60-M; AMASS_XT60-M; PARTREV V1.2
J9, J10: Conn_01x02; PinSocket_1x02_P2.54mm_Vertical
LIDAR1: Conn_01x04_Pin; JST_EH_B4B-EH-A_1x04_P2.50mm_Vertical
NRF24L1: J9; PinSocket_2x04_P2.54mm_Vertical
Oled1: Conn_01x04_Pin; OLED
Pitot1: Conn_01x03; PinHeader_1x03_P2.54mm_Vertical
R1, R2, R3, R4: 330 Ω; R_0805_2012Metric
RX1: Conn_01x03; PinHeader_1x03_P2.54mm_Vertical
SW2: SW_SPDT; Switch_Slide
TX2: Conn_01x03; PinHeader_1x03_P2.54mm_Vertical
U1: V7805-1000; 3-SIP_Module_V7805-1000; MPN V7805-1000; Digi-Key_PN 102-1715-ND
U2: ESP32-DEVKIT-V1; MODULE_ESP32_DEVKIT_V1; PARTREV N/A

Connections:
15: Encoder1.1, U2.3 (D15)
34: Pitot1.1, U2.19 (D34)
+3.3V: BMP280.1, Gy-271.1, J2.1, J3.1, J7.1, NRF24L1.1, U2.1 (3V3)
+5V: C2.1, C3.1, Encoder1.2, GPS-M10Q5883.1, J4.1, J4.2, J5.1, J5.2, J5.3, J5.4, J5.5, J5.6, J5.7, LIDAR1.2, Oled1.2, Pitot1.2, R2.1, U1.3 (Vo+), U2.30 (VIN)
ADR: J3.10, U2.28 (D13)
CE: NRF24L1.4, U2.8 (D5)
CNS: NRF24L1.3, U2.5 (D4)
CS1: J2.2, U2.4 (D2)
D12: R3.1, U2.27 (D12)
Earth: BMP280.2, BZ1.2 (+), C1.2, C2.2, C3.2, D1.1 (K), D2.1 (K), D3.1 (K), D4.1 (K), Encoder1.3, GPS-M10Q5883.6, Gy-271.2, J2.6, J3.3, J4.6, J6.1, J6.2, J6.3, J6.4, J6.5, J6.6, J6.7, J7.2, J8.N (NEG), J9.2, J10.2, LIDAR1.1, NRF24L1.2, Oled1.1, Pitot1.3, U1.2 (GND), U2.2 (GND), U2.29 (GND)
INT: J3.9, U2.26 (D14)
MISO: J2.5, NRF24L1.8, U2.10 (D19)
MOSI: J2.3, NRF24L1.5, U2.15 (D23)
unnamed: D1.2 (A), R1.2
unnamed: D2.2 (A), R2.2
unnamed: D3.2 (A), R3.2
unnamed: D4.2 (A), R4.2
unnamed: J8.P (POS), SW2.3 (C)
RX0: GPS-M10Q5883.5, U2.12 (RX0)
RX2: RX1.3, U2.6 (RX2)
SCK: J2.4, NRF24L1.6, U2.9 (D18)
SCL: BMP280.3, GPS-M10Q5883.3, Gy-271.3, J3.5, J4.4, J7.3, LIDAR1.3, Oled1.3, U2.14 (D22)
SDA: BMP280.4, GPS-M10Q5883.2, Gy-271.4, J3.4, J4.3, J7.4, LIDAR1.4, Oled1.4, U2.11 (D21)
TX0: GPS-M10Q5883.4, U2.13 (TX0)
TX2: TX2.3, U2.7 (TX2)
VCC: C1.1, J9.1, J10.1, R1.1, SW2.2 (B), U1.1 (Vin+)
VP: BZ1.1 (-), R4.1, U2.17 (VP)
ch1: J1.1, U2.23 (D25)
ch2: J1.2, U2.24 (D26)
ch3: J1.3, U2.25 (D27)
ch4: J1.4, U2.21 (D32)
ch5: J1.5, U2.22 (D33)
ch6: J1.6, U2.20 (D35)

Notes on the sheet:
I2C
UART
POWER SUPLY
SENSORS
FS-I6X
SPI
Controlador de Vuelo Delta V.10
ESP-32

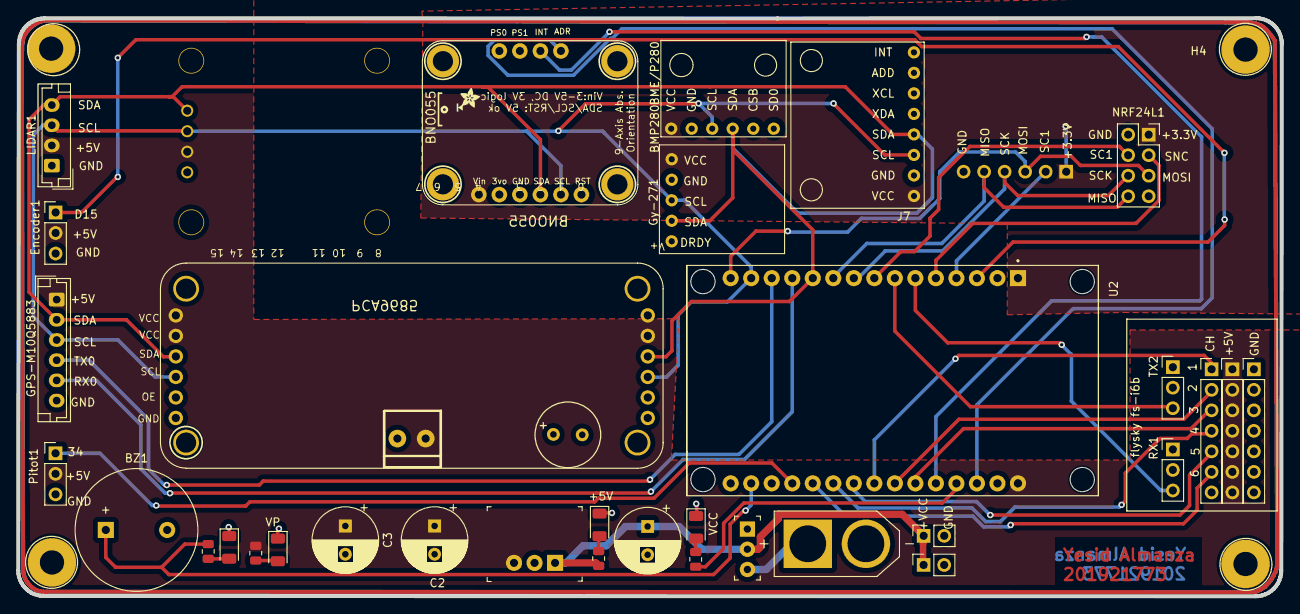
[picture p164: board src/pcb/DELTA 1.0/C1/C1.kicad_pcb from above]

Board: 2 copper layers, 156.4 x 71.6 mm, 39 parts (1 on the bottom side), 33 nets.
