YesidAlmanzaGamba/Thesis-Flight-Controller-Fixed-Wing/PCB/Huellas y Simbolos/Adafruit-BNO055/Adafruit BNO055/Adafruit BNO055.kicad_pcb

## KiCad design PCB/Huellas y Simbolos/Adafruit-BNO055/Adafruit BNO055/Adafruit BNO055.kicad_pcb (2024-11-01)

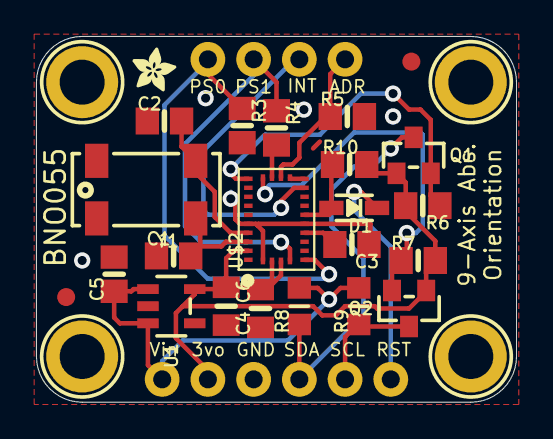
[picture p165: board Adafruit BNO055.kicad_pcb from above]

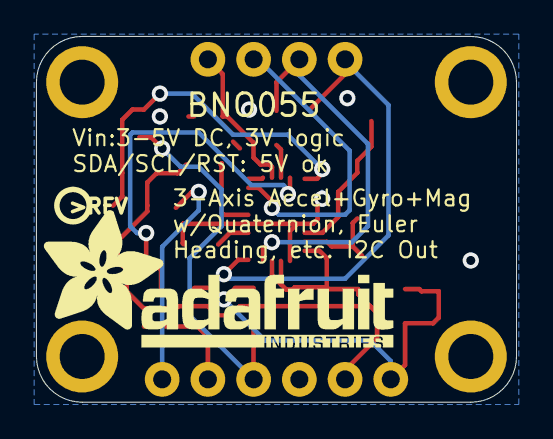
[picture p166: board Adafruit BNO055.kicad_pcb from below]

Board: 2 copper layers, 26.7 x 20.3 mm, 31 parts (2 on the bottom side), 16 nets.

Parts:
C1, C2: 22pF; 0805-NO
C3: 0.1uF; 0805-NO
C4: 0.1uF; 0805_10MGAP
C5: 10uF; 0805-NO
C6: 10uF; 0805_10MGAP
D1: 1n4148; SOD-323
FID1, FID2: FIDUCIAL""; FIDUCIAL_1MM
JP1: 1X06_ROUND_76
JP2: 1X04_ROUND_76
Q1, Q2: BSS138; SOT23-WIDE
R3, R4, R5, R6, R7, R10: 10K; 0805-NO
R8, R9: 10K; _0805MP
U1: MIC5225-3.3; SOT23-5
U$2: BNO055
U$3: PCBFEAT-REV-040
U$28: ADAFRUIT_TEXT_20MM
U$29, U$30, U$31, U$32: MOUNTINGHOLE2.5_THICK; MOUNTINGHOLE_2.5_PLATED_THICK
U$33: ADAFRUIT_2.5MM
Y1: 32.768kHz; CRYSTAL_8X3.8

Connections:
3.3V: C4.2, C6.1, JP1.2, Q1.1, Q2.1, R6.2, R7.2, R10.2, U1.5, U$2.3, U$2.4, U$2.28
5.0V: C5.1, JP1.1, R8.2, R9.2, U1.1, U1.3
GND: C1.1, C2.1, C3.1, C4.1, C5.2, C6.2, JP1.3, R3.2, R4.2, R5.2, U1.2, U$2.2, U$2.10, U$2.15, U$2.16, U$2.18, U$2.25
I2CADDR_3V: JP2.4, R5.1, U$2.17
INT_3V: JP2.3, U$2.14
unnamed: C1.2, U$2.27, Y1.P$4
unnamed: C2.2, U$2.26, Y1.P$1
unnamed: C3.2, U$2.9
NRESET_3V: D1.A, R10.1, U$2.11
PS0_3V: JP2.1, R3.1, U$2.6
PS1_3V: JP2.2, R4.1, U$2.5
RST_5V: D1.C, JP1.6
SCL_3V: Q2.2, R7.1, U$2.19
SCL_5V: JP1.5, Q2.3, R9.1
SDA_3V: Q1.2, R6.1, U$2.20
SDA_5V: JP1.4, Q1.3, R8.1
