YesidAlmanzaGamba/Thesis-Flight-Controller-Fixed-Wing/PCB/Huellas y Simbolos/Adafruit-BNO055/Adafruit BNO055.brd

## EAGLE design PCB/Huellas y Simbolos/Adafruit-BNO055/Adafruit BNO055.brd (2024-11-01)


Parts:
C1, C2: 22pF; 0805-NO
C3: 0.1uF; 0805-NO
C4: 0.1uF; 0805_10MGAP
C5: 10uF; 0805-NO
C6: 10uF; 0805_10MGAP
D1: 1n4148; SOD-323
FID1, FID2: FIDUCIAL""; FIDUCIAL_1MM
JP1: HEADER-1X676MIL; 1X06_ROUND_76
JP2: HEADER-1X476MIL; 1X04_ROUND_76
Q1, Q2: BSS138; SOT23-WIDE
R3, R4, R5, R6, R7, R10: 10K; 0805-NO
R8, R9: 10K; _0805MP
U1: MIC5225-3.3; SOT23-5
U$2: BNO055
U$29, U$30, U$31, U$32: MOUNTINGHOLE2.5_THICK; MOUNTINGHOLE_2.5_PLATED_THICK
Y1: 32.768kHz; CRYSTAL_8X3.8

Connections:
3.3V: C4.2, C6.1, JP1.2, Q1.1 (G), Q2.1 (G), R6.2, R7.2, R10.2, U1.5 (OUT), U$2.3 (VDD), U$2.4 (NBOOT_LOAD_PIN), U$2.28 (VDDIO)
5.0V: C5.1, JP1.1, R8.2, R9.2, U1.1 (IN), U1.3 (EN)
GND: C1.1, C2.1, C3.1, C4.1, C5.2, C6.2, JP1.3, R3.2, R4.2, R5.2, U1.2 (GND), U$2.2 (GND), U$2.10 (PIN10(GND)), U$2.15 (PIN15(GND)), U$2.16 (PIN16(GND)), U$2.18 (COM2(GND)), U$2.25 (GND)
I2CADDR_3V: JP2.4, R5.1, U$2.17 (COM3/I2C_ADDR)
INT_3V: JP2.3, U$2.14 (INT)
unnamed: C1.2, U$2.27 (XIN32), Y1.P$4 (2)
unnamed: C2.2, U$2.26 (XOUT32), Y1.P$1 (1)
unnamed: C3.2, U$2.9 (CAP)
NRESET_3V: D1.A, R10.1, U$2.11 (NRESET)
PS0_3V: JP2.1, R3.1, U$2.6 (PS0)
PS1_3V: JP2.2, R4.1, U$2.5 (PS1)
RST_5V: D1.C, JP1.6
SCL_3V: Q2.2 (S), R7.1, U$2.19 (COM1/SCL/RX)
SCL_5V: JP1.5, Q2.3 (D), R9.1
SDA_3V: Q1.2 (S), R6.1, U$2.20 (COM0/SDA/TX)
SDA_5V: JP1.4, Q1.3 (D), R8.1



Board: 2 copper layers, 26.7 x 20.3 mm, 31 parts (2 on the bottom side), 16 nets.

Other parts of the board:
U$3: PCBFEAT-REV-040
U$28: ADAFRUIT_TEXT_20MM
U$33: ADAFRUIT_2.5MM
