YesidAlmanzaGamba/Thesis-Flight-Controller-Fixed-Wing/PCB/Huellas y Simbolos/Adafruit-BNO055/Adafruit BNO055 STEMMA QT.brd

## EAGLE design PCB/Huellas y Simbolos/Adafruit-BNO055/Adafruit BNO055 STEMMA QT.brd (2024-11-01)

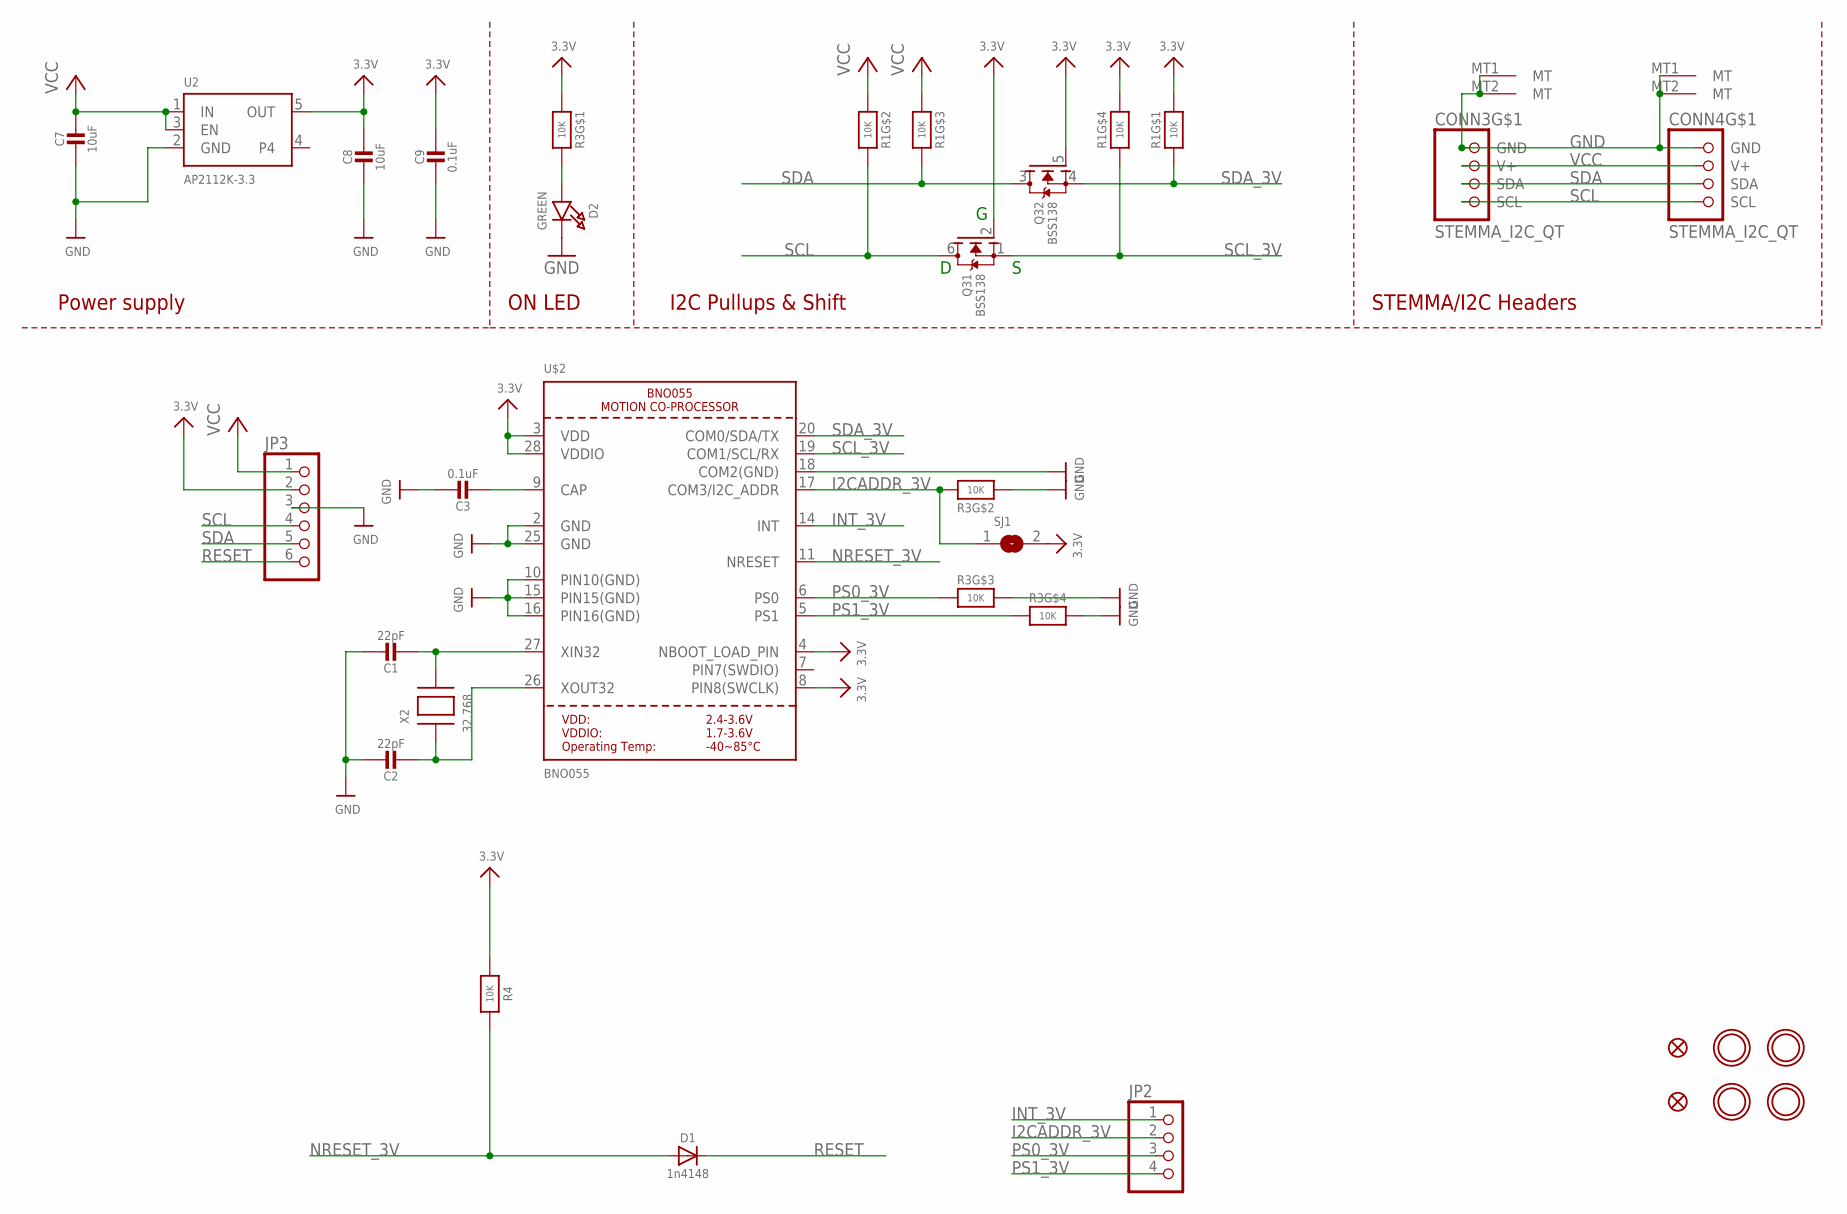
[picture p170: schematic Adafruit BNO055 STEMMA QT.sch]

Parts:
C1, C2: 22pF; 0603-NO
C3, C9: 0.1uF; 0603-NO
C7, C8: 10uF; 0805-NO
CONN3, CONN4: STEMMA_I2C_QT; JST_SH4
D1: 1n4148; SOD-323
D2: GREEN; CHIPLED_0603_NOOUTLINE
FID3, FID4: FIDUCIAL_1MM
JP2: HEADER-1X476MIL; 1X04_ROUND_76
JP3: HEADER-1X670MIL; 1X06_ROUND_70
Q3: BSS138; SOT363
R1, R3: 10K; RESPACK_4X0603
R4: 10K; 0603-NO
SJ1: SOLDERJUMPER; SOLDERJUMPER_ARROW_NOPASTE
U2: AP2112K-3.3; SOT23-5
U$2: BNO055
U$45, U$46, U$48, U$49: MOUNTINGHOLE2.5; MOUNTINGHOLE_2.5_PLATED
X2: 32.768; XTAL3215

Connections:
3.3V: C8.1, C9.1, JP3.2, Q3.2 (G), Q3.5 (G), R1.1, R1.4 (1), R3.1, R4.1, SJ1.2, U2.5 (OUT), U$2.3 (VDD), U$2.4 (NBOOT_LOAD_PIN), U$2.8 (PIN8(SWCLK)), U$2.28 (VDDIO)
GND: C1.1, C2.1, C3.1, C7.2, C8.2, C9.2, CONN3.1 (GND), CONN3.MT1 (MT), CONN3.MT2 (MT), CONN4.1 (GND), CONN4.MT1 (MT), CONN4.MT2 (MT), D2.C, JP3.3, R3.2 (1), R3.5 (2), R3.6 (2), U2.2 (GND), U$2.2 (GND), U$2.10 (PIN10(GND)), U$2.15 (PIN15(GND)), U$2.16 (PIN16(GND)), U$2.18 (COM2(GND)), U$2.25 (GND)
I2CADDR_3V: JP2.2, R3.7 (2), SJ1.1, U$2.17 (COM3/I2C_ADDR)
INT_3V: JP2.1, U$2.14 (INT)
unnamed: C1.2, U$2.27 (XIN32), X2.P$2
unnamed: C2.2, U$2.26 (XOUT32), X2.P$1
unnamed: C3.2, U$2.9 (CAP)
unnamed: D2.A, R3.8 (2)
NRESET_3V: D1.A, R4.2, U$2.11 (NRESET)
PS0_3V: JP2.3, R3.3 (1), U$2.6 (PS0)
PS1_3V: JP2.4, R3.4 (1), U$2.5 (PS1)
RESET: D1.C, JP3.6
SCL: CONN3.4 (SCL), CONN4.4 (SCL), JP3.4, Q3.6 (D), R1.7 (2)
SCL_3V: Q3.1 (S), R1.5 (2), U$2.19 (COM1/SCL/RX)
SDA: CONN3.3 (SDA), CONN4.3 (SDA), JP3.5, Q3.3 (D), R1.6 (2)
SDA_3V: Q3.4 (S), R1.8 (2), U$2.20 (COM0/SDA/TX)
VCC: C7.1, CONN3.2 (V+), CONN4.2 (V+), JP3.1, R1.2 (1), R1.3 (1), U2.1 (IN), U2.3 (EN)

Notes on the sheet:
I2C Pullups & Shift
STEMMA/I2C Headers
ON LED
Power supply

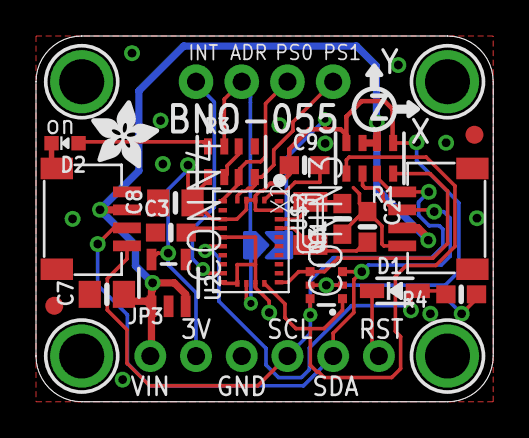
[picture p171: board Adafruit BNO055 STEMMA QT.brd from above]

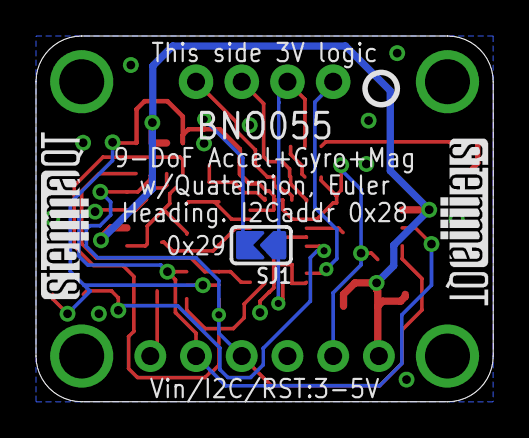
[picture p172: board Adafruit BNO055 STEMMA QT.brd from below]

Board: 2 copper layers, 25.4 x 20.3 mm, 30 parts (4 on the bottom side), 17 nets.

Other parts of the board:
U$51: ADAFRUIT_3.5MM
U$52: PCBFEAT-REV-040
U$53, U$54: STEMMAQT
