YesidAlmanzaGamba/Thesis-Flight-Controller-Fixed-Wing/(commit log)

2024-11-01 Document Little Fix
    [4646 BNO055 Stemma.step, Adafruit BNO055 STEMMA QT.brd, Adafruit BNO055 STEMMA QT.sch, Adafruit BNO055.brd, Adafruit BNO055.kicad_pcb, Adafruit BNO055.sch, Adafruit PCA9685 rev C.brd, Adafruit PCA9685 rev C.sch]
2024-11-05 PCB documents add
    [4646 BNO055 Stemma.step, Adafruit BNO055 STEMMA QT.brd, Adafruit BNO055 STEMMA QT.sch, Adafruit BNO055.brd, Adafruit BNO055.kicad_pcb, Adafruit BNO055.sch, Adafruit PCA9685 rev C.brd, Adafruit PCA9685 rev C.sch]
2024-11-07 Code For Working Flight Controller and GCS--------------------------------@simonpine
    [C1-B_Cu.gbr, C1-B_Mask.gbr, C1-B_Paste.gbr, C1-B_Silkscreen.gbr, C1-F_Cu.gbr, C1-F_Mask.gbr, C1-F_Paste.gbr, C1-F_Silkscreen.gbr]
2026-10-16 Add README, GCS requirements and clean up tracked build artifacts
    - Rewrite README with project overview, video, build/run instructions and citation
    - Add requirements.txt for the PyQt5 ground control station
    - Extend .gitignore (PlatformIO, LaTeX aux files, Python, OS noise)
    - Untrack .pio/, LaTeX build outputs, machine-specific VS Code config and JVM crash logs
